davidholmes1066/LPM_Production_TT/Matlab_GUI/TRANSUS.png

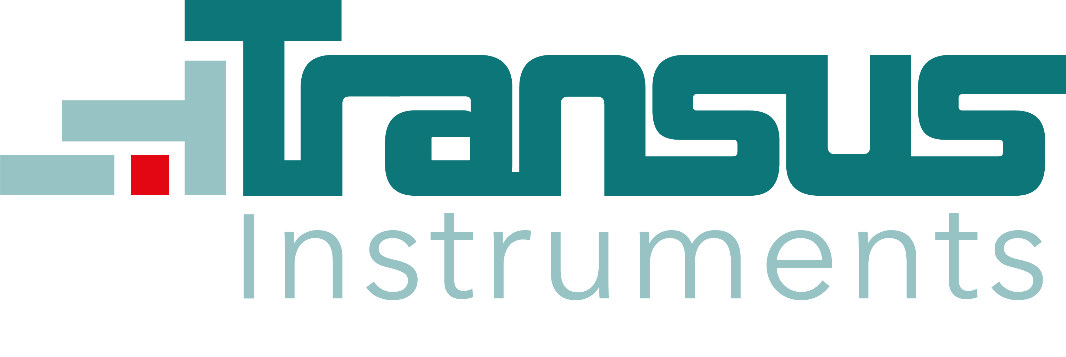
Matlab_GUI/TRANSUS.png
