davidholmes1066/LPM_Production_TT/Boards/Cover.dxf

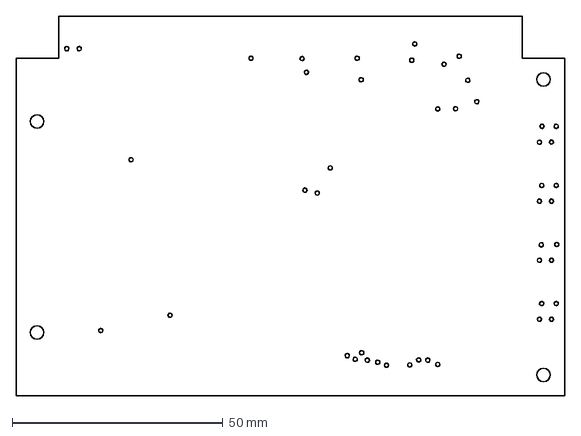
[picture p2: CAD file, 2023-02-11]
Boards/Cover.dxf
130.0 x 90.0 mm
