davidholmes1066/LPM_Production_TT/Boards/LPM_AJ_BEDOFNAILS/Bed_of_nails/Bed_of_nails.step

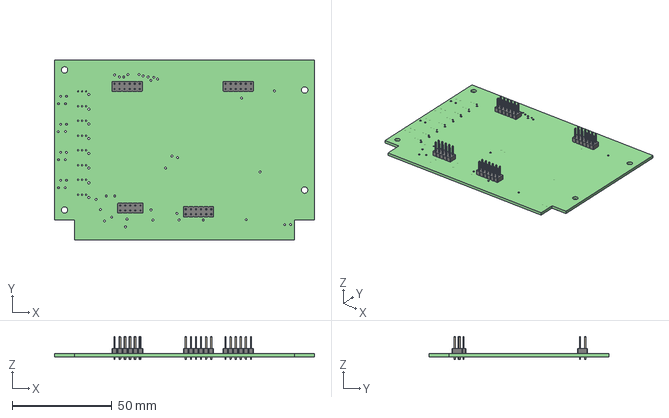
[picture p3: CAD file, 2023-02-11]
Boards/LPM_AJ_BEDOFNAILS/Bed_of_nails/Bed_of_nails.step
130.0 x 90.0 x 11.5 mm
_autosave-Bed_of_nails PCB
