davidholmes1066/LPM_Production_TT/Boards/test_board_boost/bigbirtha.dxf

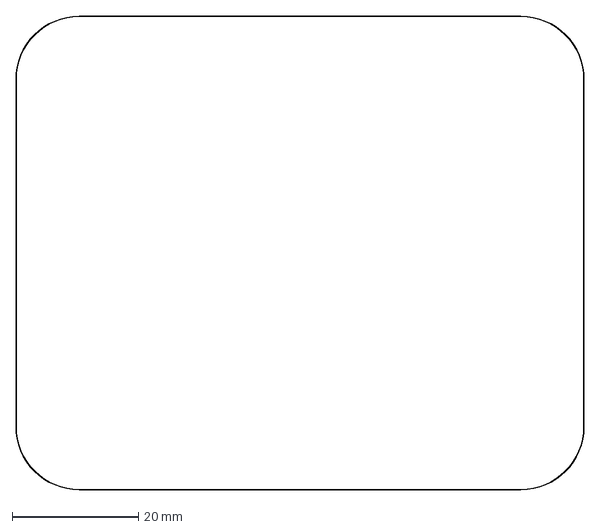
[picture p4: CAD file, 2023-02-11]
Boards/test_board_boost/bigbirtha.dxf
90.0 x 75.0 mm
