davidholmes1066/LPM_Production_TT/Boards/LPM_AJ_BEDOFNAILS/Bed_of_nails/Bed_of_nails-Edge_Cuts.dxf

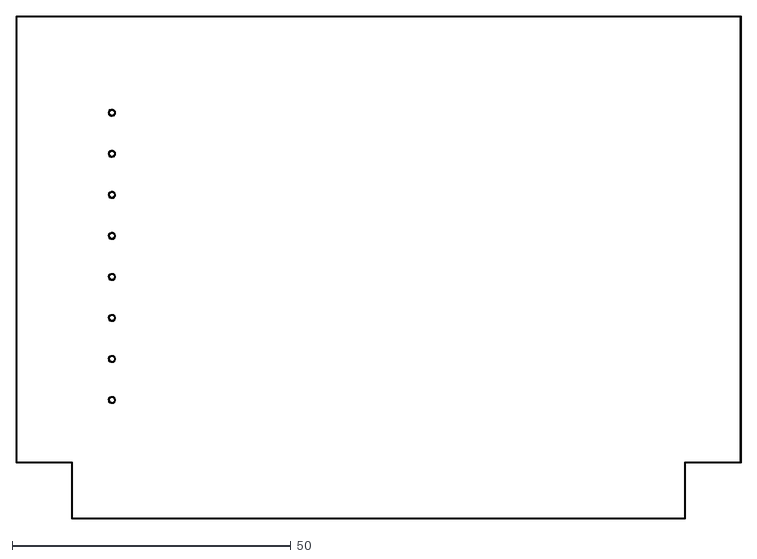
[picture p5: CAD file, 2023-02-11]
Boards/LPM_AJ_BEDOFNAILS/Bed_of_nails/Bed_of_nails-Edge_Cuts.dxf
130.1 x 90.1
