davidholmes1066/LPM_Production_TT/Boards/test_board_boost/step2dxf.step

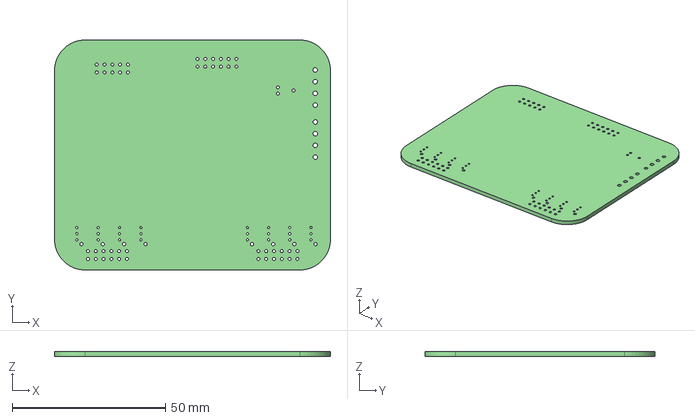
[picture p6: CAD file, 2023-02-11]
Boards/test_board_boost/step2dxf.step
90.0 x 75.0 x 1.60 mm
