davidholmes1066/LPM_Production_TT/Boards/test_board_boost/edgecut.dxf

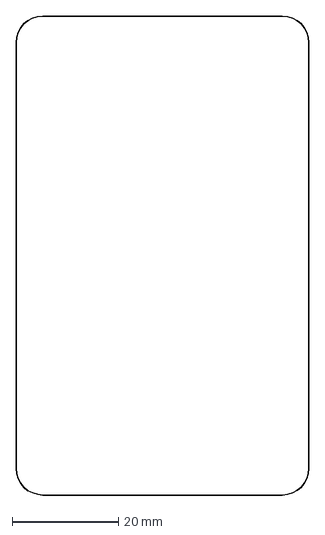
[picture p7: CAD file, 2023-02-11]
Boards/test_board_boost/edgecut.dxf
55.0 x 90.0 mm
