davidholmes1066/LPM_Production_TT/(list of files, cad)

Other CAD files:
Boards/Coverboard/Coverboard-B_Silkscreen.dxf
Boards/Coverboard/Coverboard-F_Silkscreen.dxf
Boards/LPM_AJ_BEDOFNAILS/Bed_of_nails/Bed_of_nails-B_Silkscreen.dxf
Boards/LPM_AJ_BEDOFNAILS/Bed_of_nails/Bed_of_nails-F_Silkscreen.dxf
Boards/USB/USB-B_Silkscreen.dxf
Boards/USB/USB-F_Silkscreen.dxf
Boards/test_board_boost/test_board_boost-B_Silkscreen.dxf
Boards/test_board_boost/test_board_boost-F_Silkscreen.dxf
