davidholmes1066/LPM_Production_TT/Matlab_GUI/logfiles/test123_11-02-2023.xlsx

Sheet: Logfile
Serial number | Date | PASS/ FAIL | VCC MAIN | CORE VDD | VDD 1.8 | VIO 3.0 | VPP | VIO 1.8 | BLE VDD | IBAT | IEXT | F D0 | F D1 | VOS P1 | VOS P2 | VOS P3 | VOS P4 | SNR P1U | SNR P1D | SNR P2U | SNR P2D | SNR P3U | SNR P3D | SNR P4U | SNR P4D | GAIN P1U | GAIN P1D | GAIN P2U | GAIN P2D | GAIN P3U | GAIN P3D | GAIN P4U | GAIN P4D | TEMP | PRES
test13 | 2023-02-11 19:50 | FAIL | -0.06685973437 | -0.1814976738 | -0.1859932793 | -0.1814976738 | -0.08034655078 | -0.188241082 | -0.1927366875 | 298.8080611 | -39.20463423 |  |  | 10.85872955 | 9.197671127 | 11.78317356 | 10.23971558 | 10.88460846 | 11.09811764 | 57.50366516 | 57.6351265 | 5721 | 5721 | 5566 | 18371 | 20480 | 20480

Sheet: Parameters
Test Parameters
 | VCC MAIN | CORE VDD | VDD 1.8 | VIO 3.0 | VPP | VIO 1.8 | BLE VDD | IBAT | IEXT | VOS | SNR | GAIN | Frequency | Temp | Pres
MIN | 3.22 | 1.15 | 1.76 | 2.93 | 2.43 | 1.76 | 2.93 |  |  | 308.7 | 45 | 30000 | 990 | 10 | 0.5
MAX | 3.38 | 1.25 | 1.88 | 3.07 | 2.57 | 1.88 | 3.07 | 310 | 710 | 377.3 |  | 50000 | 1010 | 600 | 100
