davidholmes1066/LPM_Production_TT/Matlab_GUI/logfiles/TEST_12-02-2023.xlsx

Sheet: Logfile
Serial number | Date | PASS/ FAIL | VCC MAIN | CORE VDD | VDD 1.8 | VIO 3.0 | VPP | VIO 1.8 | BLE VDD | IBAT | IEXT | F D0 | F D1 | VOS P1 | VOS P2 | VOS P3 | VOS P4 | SNR P1U | SNR P1D | SNR P2U | SNR P2D | SNR P3U | SNR P3D | SNR P4U | SNR P4D | GAIN P1U | GAIN P1D | GAIN P2U | GAIN P2D | GAIN P3U | GAIN P3D | GAIN P4U | GAIN P4D | TEMP | PRES
TEST | 2023-02-12 09:18 | FAIL | -0.06461193164 | -0.1680108574 | -0.188241082 | -0.1814976738 | -0.07585094531 | -0.1770020684 | -0.1904888848 | 301.3715376 | -38.8384233 |  |  | 18371 | 20480 | 20480 | 0 | 11.58883743 | 11.45199604 | 12.74043026 | 13.6725668 | 10.7099968 | 12.111866 | 49.49263916 | 45.45700607 | 5721 | 5721 | 5721 | 5721 | 5566 | 5566 | 114 | 114 | -0.1778589338 | 269.9919128
1325 | 2023-02-12 10:22 | FAIL | -0.003921257812 | -0.1837454766 | -0.1747542656 | -0.163515252 | -0.01066466602 | -0.1904888848 | -0.1792498711 | 301.3715376 | -38.8384233 |  |  | 18371 | 20480 | 20480 | 0 | 12.20718956 | 9.656385422 | 10.95156097 | 10.90866089 | 10.4581995 | 9.892720222 | 41.48161316 | 41.3976326 | 5721 | 5721 | 5721 | 5721 | 5566 | 5566 | 68.4 | 68.4 | -0.1782969534 | 269.9919128
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
