davidholmes1066/LPM_Production_TT/Boards/test_board_boost/TIP023BF_SCH.pdf

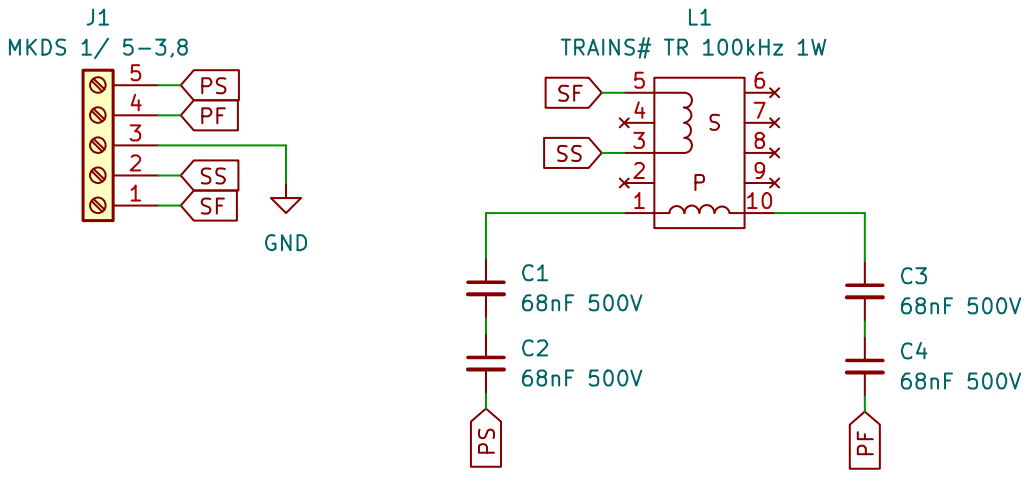
[picture p8: page 1]
