davidholmes1066/LPM_Production_TT/Boards/test_board_boost/test_board_boost.kicad_pcb

## KiCad design Boards/test_board_boost/test_board_boost.kicad_pcb (2024-06-26)

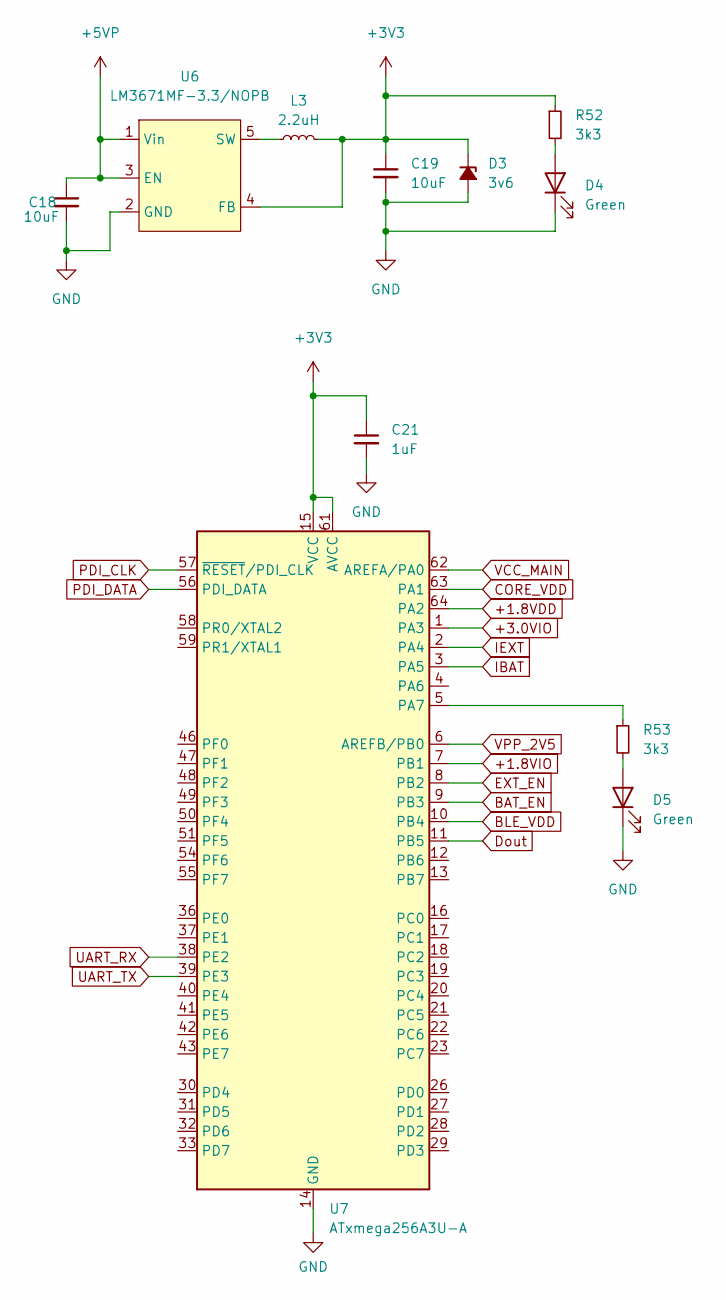
[picture p9: schematic MCU.kicad_sch]

Parts:
C18, C19: 10uF; C_0805_2012Metric_Pad1.18x1.45mm_HandSolder
C21: 1uF; C_0805_2012Metric_Pad1.18x1.45mm_HandSolder; Farnell 2346944
D3: 3v6; BZX84C3V6; Farnell 1902466
D4, D5: Green; LED_0402_1005Metric_Pad0.77x0.64mm_HandSolder; Farnell 2507544
L3: 2.2uH; 10uH_boost; Farnell 3865051
R52, R53: 3k3; R_0805_2012Metric_Pad1.20x1.40mm_HandSolder
U6: LM3671MF-3.3/NOPB; SOT-23-5_HandSoldering; Farnell 3008192
U7: ATxmega256A3U-A; TQFP-64_14x14mm_P0.8mm

Connections:
+1.8VDD: U7.64 (PA2); also elsewhere on the board
+1.8VIO: U7.7 (PB1); also elsewhere on the board
+3.0VIO: U7.1 (PA3); also elsewhere on the board
+3V3: C19.1, C21.1, D3.1 (K), L3.2, R52.1, U6.4 (FB), U7.15 (VCC), U7.25 (VCC), U7.35 (VCC), U7.45 (VCC), U7.53 (VCC), U7.61 (AVCC); also elsewhere on the board
+5VP: C18.1, U6.1 (Vin), U6.3 (EN); also elsewhere on the board
BAT_EN: U7.9 (PB3); also elsewhere on the board
BLE_VDD: U7.10 (PB4); also elsewhere on the board
CORE_VDD: U7.63 (PA1); also elsewhere on the board
Dout: U7.11 (PB5); also elsewhere on the board
EXT_EN: U7.8 (PB2); also elsewhere on the board
GND: C18.2, C19.2, C21.2, D3.2 (A), D4.1 (K), D5.1 (K), U6.2 (GND), U7.14 (GND), U7.24 (GND), U7.34 (GND), U7.44 (GND), U7.52 (GND), U7.60 (GND); also elsewhere on the board
IBAT: U7.3 (PA5); also elsewhere on the board
IEXT: U7.2 (PA4); also elsewhere on the board
unnamed: D4.2 (A), R52.2
unnamed: D5.2 (A), R53.2
unnamed: L3.1, U6.5 (SW)
unnamed: R53.1, U7.5 (PA7)
PDI_CLK: U7.57 (~RESET/PDI_CLK); also elsewhere on the board
PDI_DATA: U7.56 (PDI_DATA); also elsewhere on the board
UART_RX: U7.38 (PE2); also elsewhere on the board
UART_TX: U7.39 (PE3); also elsewhere on the board
VCC_MAIN: U7.62 (AREFA/PA0); also elsewhere on the board
VPP_2V5: U7.6 (AREFB/PB0); also elsewhere on the board

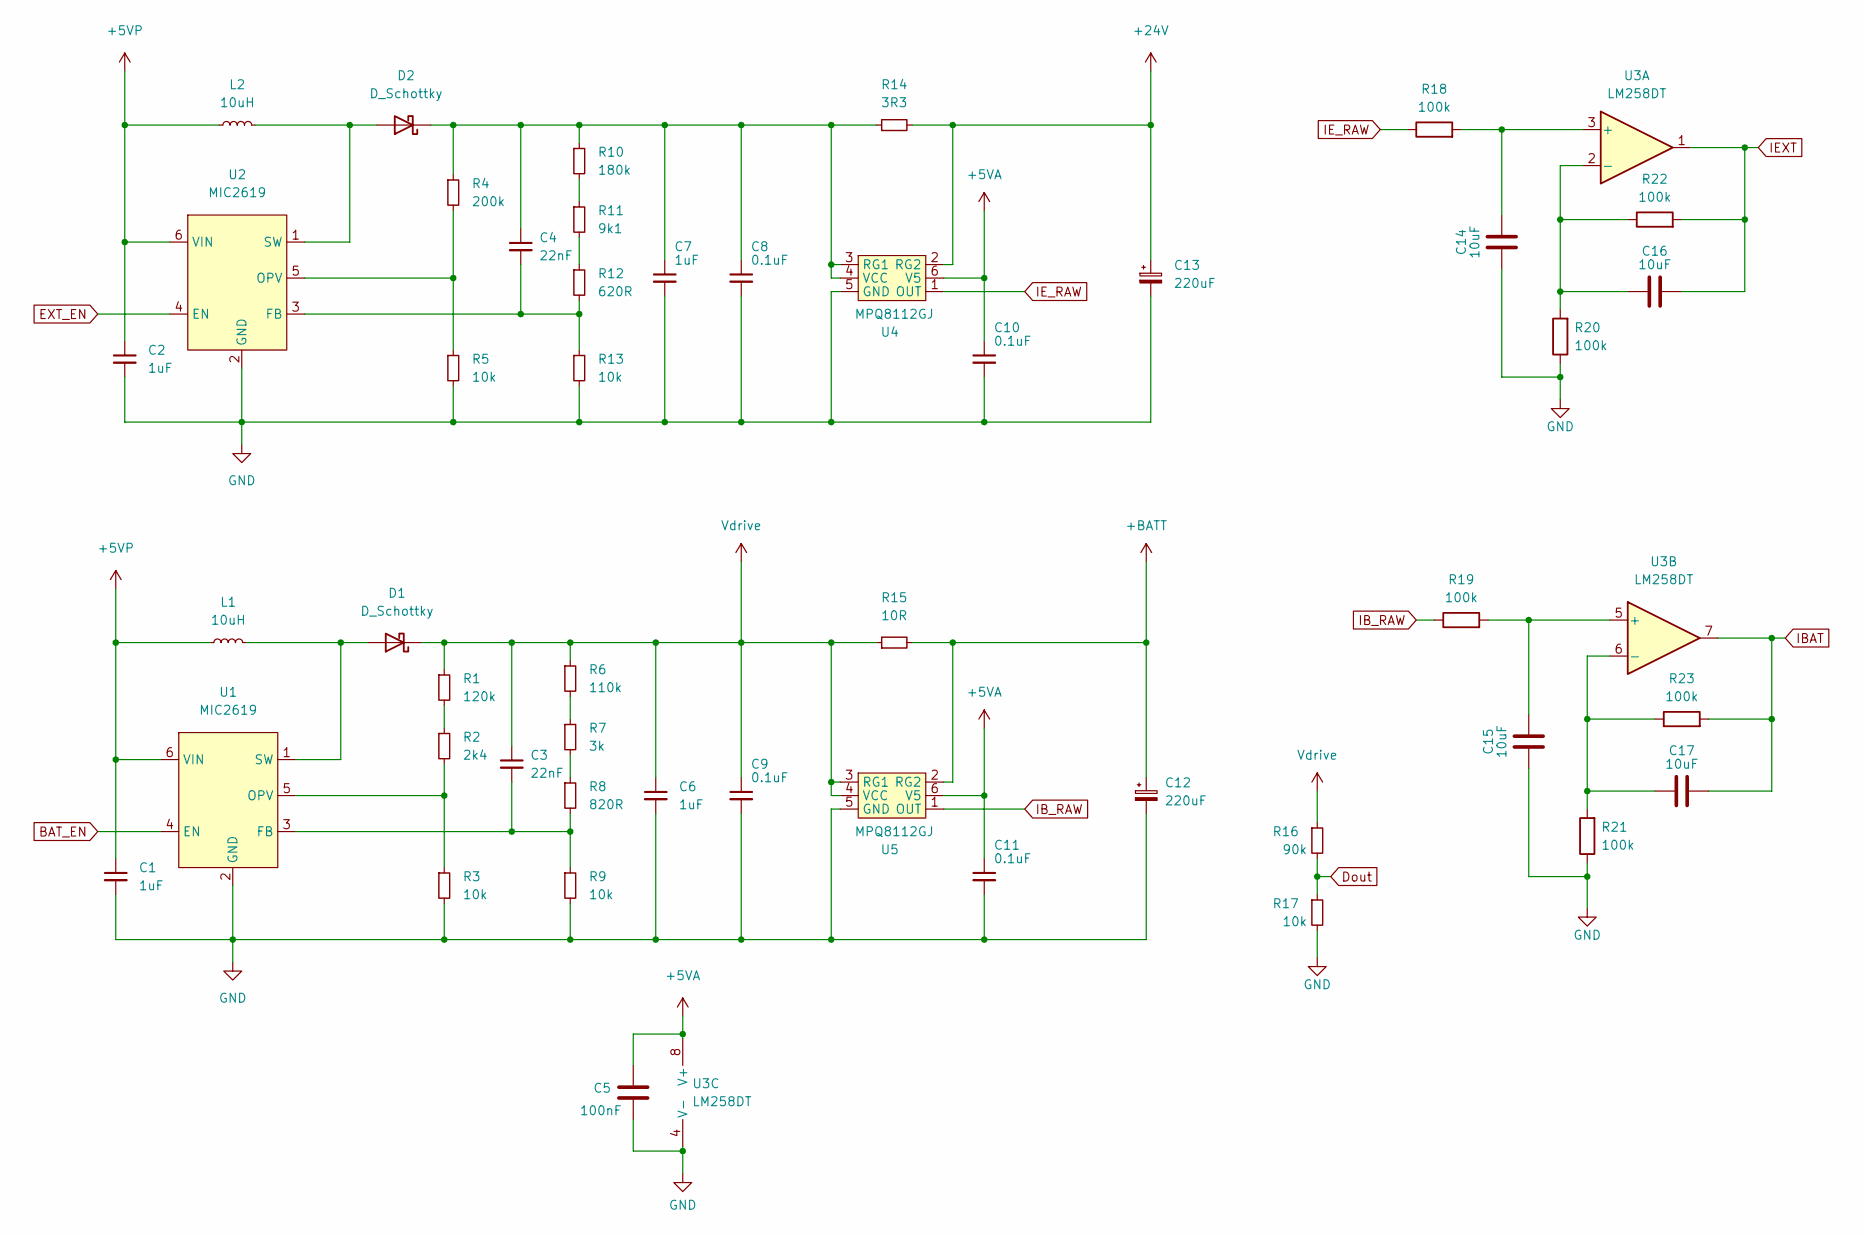
[picture p10: schematic LPM_SUP.kicad_sch]

Parts:
C1, C2, C7: 1uF; C_0805_2012Metric_Pad1.18x1.45mm_HandSolder; Farnell 2346944
C3, C4: 22nF; C_0805_2012Metric_Pad1.18x1.45mm_HandSolder
C5: 100nF; C_0805_2012Metric_Pad1.18x1.45mm_HandSolder; FARNELL 2611936
C6: 1uF; C_0805_2012Metric_Pad1.18x1.45mm_HandSolder
C8, C9, C10, C11: 0.1uF; C_0805_2012Metric_Pad1.18x1.45mm_HandSolder
C12, C13: 220uF; CP_Elec_10x10; Farnell 2471976
C14, C15, C16, C17: 10uF; C_0805_2012Metric_Pad1.18x1.45mm_HandSolder; FARNELL 2611936
D1, D2: D_Schottky; D_SOD-323; Farnell 1467544
L1, L2: 10uH; 10uH_boost; Farnell 3865054
R1: 120k; R_0805_2012Metric_Pad1.20x1.40mm_HandSolder
R2: 2k4; R_0805_2012Metric_Pad1.20x1.40mm_HandSolder
R3, R5, R9, R13, R17: 10k; R_0805_2012Metric_Pad1.20x1.40mm_HandSolder
R4: 200k; R_0805_2012Metric_Pad1.20x1.40mm_HandSolder
R6: 110k; R_0805_2012Metric_Pad1.20x1.40mm_HandSolder
R7: 3k; R_0805_2012Metric_Pad1.20x1.40mm_HandSolder
R8: 820R; R_0805_2012Metric_Pad1.20x1.40mm_HandSolder
R10: 180k; R_0805_2012Metric_Pad1.20x1.40mm_HandSolder
R11: 9k1; R_0805_2012Metric_Pad1.20x1.40mm_HandSolder
R12: 620R; R_0805_2012Metric_Pad1.20x1.40mm_HandSolder
R14: 3R3; R_0805_2012Metric_Pad1.20x1.40mm_HandSolder
R15: 10R; R_0805_2012Metric_Pad1.20x1.40mm_HandSolder
R16: 90k; R_0805_2012Metric_Pad1.20x1.40mm_HandSolder
R18, R19, R20, R21, R22, R23: 100k; R_0805_2012Metric_Pad1.20x1.40mm_HandSolder
U1, U2: MIC2619; MIC2619YD6-TR; Farnell 2509963
U3: LM258DT; SO-8_5.3x6.2mm_P1.27mm; Farnell 2382607
U4, U5: MPQ8112GJ; SOT-23-6_Handsoldering; Farnell 3922485

Connections:
+5VP: C1.1, C2.1, C5.1, C10.1, C11.1, L1.1, L2.1, U1.6 (VIN), U2.6 (VIN), U3.8 (V+), U4.6 (V5), U5.6 (V5); also elsewhere on the board
+24V: C13.1, R14.2, U4.2 (RG2); also elsewhere on the board
+BATT: C12.1, R15.2, U5.2 (RG2); also elsewhere on the board
BAT_EN: U1.4 (EN); also elsewhere on the board
Dout: R16.2, R17.1; also elsewhere on the board
EXT_EN: U2.4 (EN); also elsewhere on the board
GND: C1.2, C2.2, C5.2, C6.2, C7.2, C8.2, C9.2, C10.2, C11.2, C12.2, C13.2, C14.1, C15.1, R3.2, R5.2, R9.2, R13.2, R17.2, R20.1, R21.1, U1.2 (GND), U2.2 (GND), U3.4 (V-), U4.5 (GND), U5.5 (GND); also elsewhere on the board
IBAT: C17.2, R23.2, U3.7; also elsewhere on the board
IB_RAW: R19.1, U5.1 (OUT)
IEXT: C16.2, R22.2, U3.1; also elsewhere on the board
IE_RAW: R18.1, U4.1 (OUT)
unnamed: C3.2, R8.2, R9.1, U1.3 (FB)
unnamed: C4.1, C7.1, C8.1, D2.1 (K), R4.1, R10.1, R14.1, U4.3 (RG1), U4.4 (VCC)
unnamed: C4.2, R12.2, R13.1, U2.3 (FB)
unnamed: C14.2, R18.2, U3.3 (+)
unnamed: C15.2, R19.2, U3.5 (+)
unnamed: C16.1, R20.2, R22.1, U3.2 (-)
unnamed: C17.1, R21.2, R23.1, U3.6 (-)
unnamed: D1.2 (A), L1.2, U1.1 (SW)
unnamed: D2.2 (A), L2.2, U2.1 (SW)
unnamed: R1.2, R2.1
unnamed: R2.2, R3.1, U1.5 (OPV)
unnamed: R4.2, R5.1, U2.5 (OPV)
unnamed: R6.2, R7.1
unnamed: R7.2, R8.1
unnamed: R10.2, R11.1
unnamed: R11.2, R12.1
Vdrive: C3.1, C6.1, C9.1, D1.1 (K), R1.1, R6.1, R15.1, R16.1, U5.3 (RG1), U5.4 (VCC)

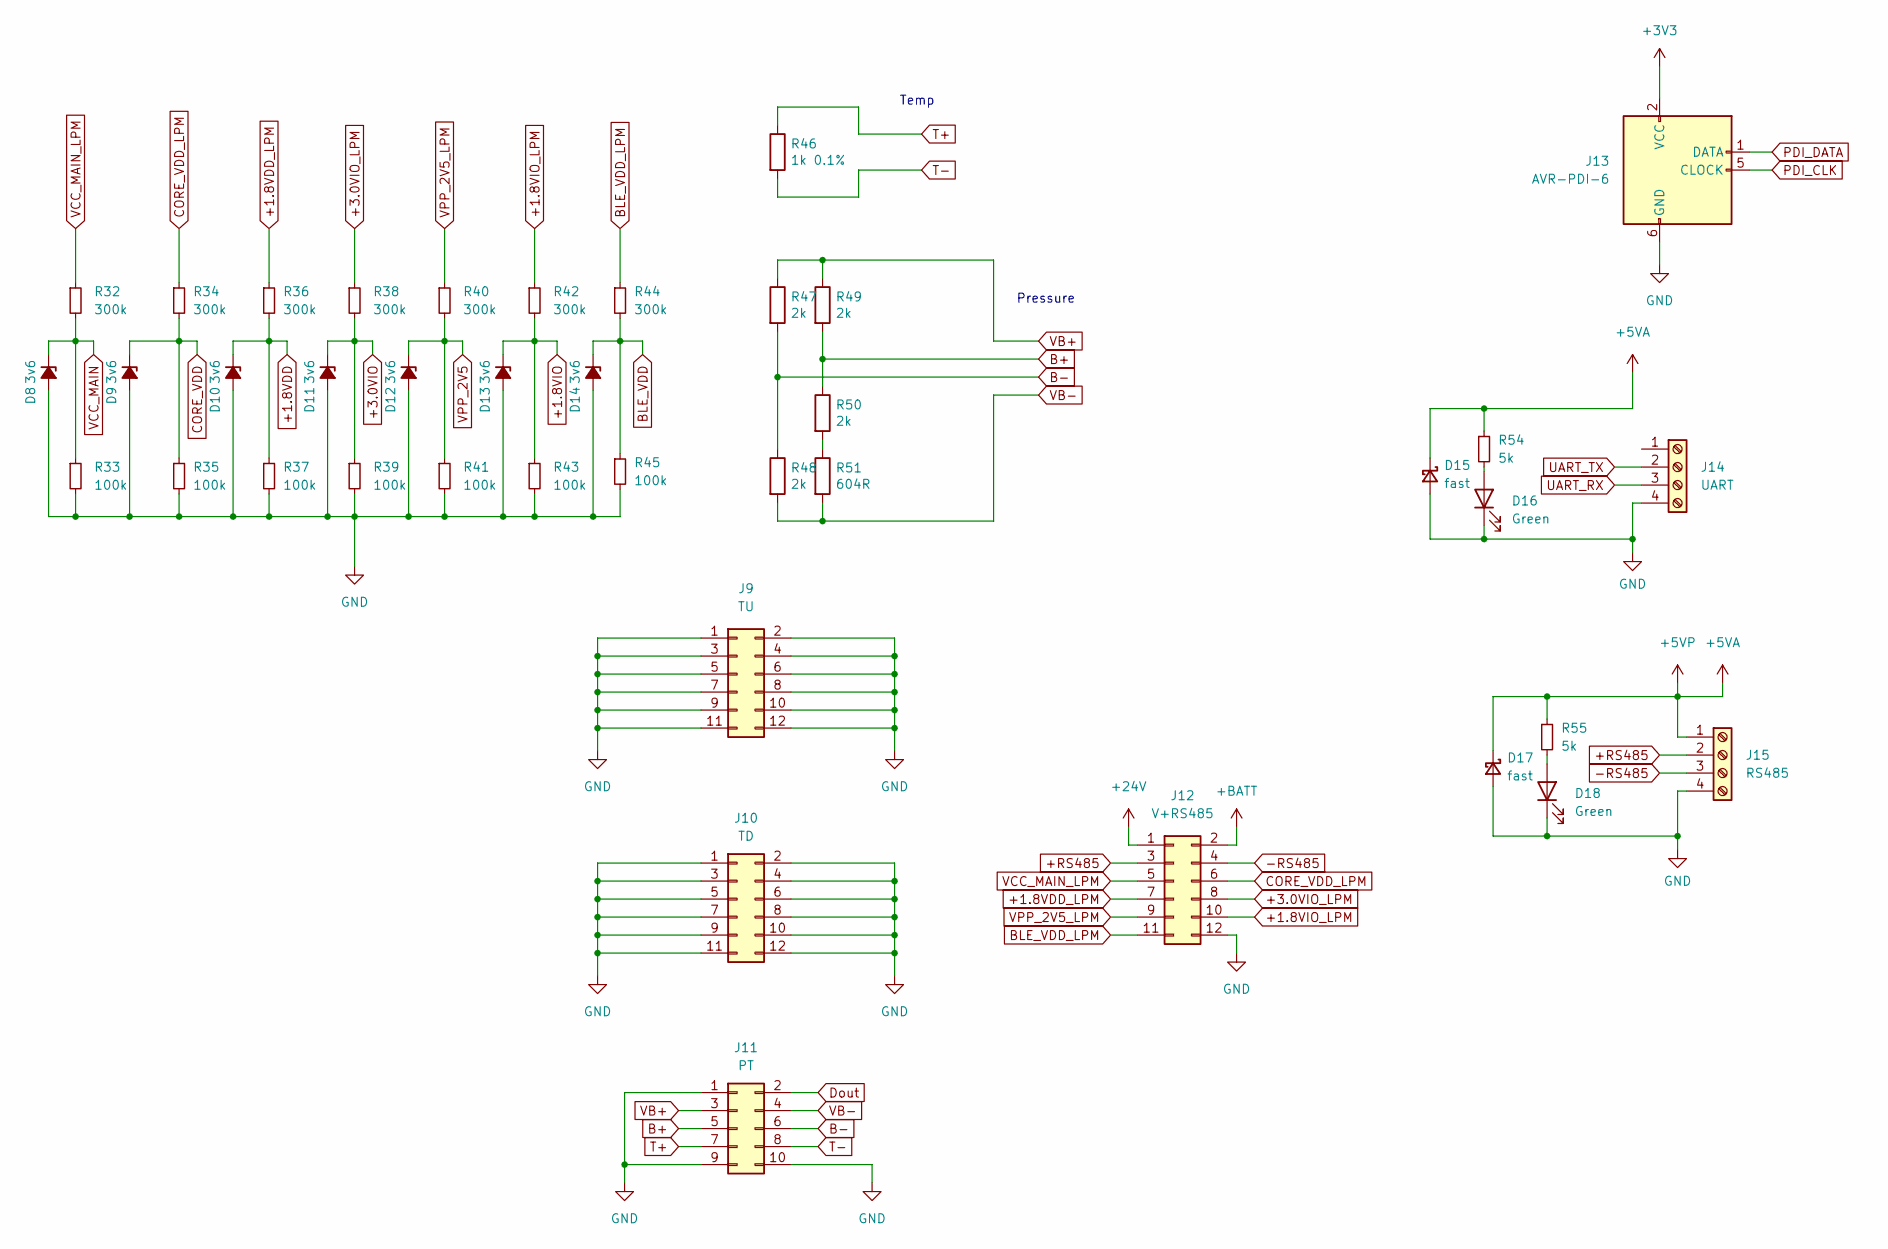
[picture p11: schematic cons.kicad_sch]

Parts:
D8, D9, D10, D11, D12, D13, D14: 3v6; BZX84C3V6; Farnell 1902466
D15, D17: fast; D_SOD-128; Farnell 1829204
D16, D18: Green; LED_0402_1005Metric_Pad0.77x0.64mm_HandSolder; Farnell 2507544
J9: TU; PinHeader_2x06_P2.54mm_Vertical
J10: TD; PinHeader_2x06_P2.54mm_Vertical
J11: PT; PinHeader_2x05_P2.54mm_Vertical
J12: V+RS485; PinHeader_2x06_P2.54mm_Vertical
J13: AVR-PDI-6; AVR-PDI-TAG-CONNECT
J14: UART; 4pos_terminal; Farnell 2007987
J15: RS485; 4pos_terminal; Farnell 2007987
R32, R34, R36, R38, R40, R42, R44: 300k; R_0805_2012Metric_Pad1.20x1.40mm_HandSolder
R33, R35, R37, R39, R41, R43, R45: 100k; R_0805_2012Metric_Pad1.20x1.40mm_HandSolder
R46: 1k 0.1%; R_0805_2012Metric_Pad1.20x1.40mm_HandSolder
R47, R48, R49, R50: 2k; R_0805_2012Metric_Pad1.20x1.40mm_HandSolder
R51: 604R; R_0805_2012Metric_Pad1.20x1.40mm_HandSolder
R54, R55: 5k; R_0805_2012Metric_Pad1.20x1.40mm_HandSolder

Connections:
+1.8VDD: D10.1 (K), R36.2, R37.1; also elsewhere on the board
+1.8VDD_LPM: J12.7, R36.1
+1.8VIO: D13.1 (K), R42.2, R43.1; also elsewhere on the board
+1.8VIO_LPM: J12.10, R42.1
+3.0VIO: D11.1 (K), R38.2, R39.1; also elsewhere on the board
+3.0VIO_LPM: J12.8, R38.1
+3V3: J13.2 (VCC); also elsewhere on the board
+5VP: D15.1 (K), D17.1 (K), J15.1, R54.1, R55.1; also elsewhere on the board
+24V: J12.1; also elsewhere on the board
+BATT: J12.2; also elsewhere on the board
+RS485: J12.3, J15.2
-RS485: J12.4, J15.3
B+: J11.5, R49.2, R50.1
B-: J11.6, R47.2, R48.1
BLE_VDD: D14.1 (K), R44.2, R45.1; also elsewhere on the board
BLE_VDD_LPM: J12.11, R44.1
CORE_VDD: D9.1 (K), R34.2, R35.1; also elsewhere on the board
CORE_VDD_LPM: J12.6, R34.1
Dout: J11.2; also elsewhere on the board
GND: D8.2 (A), D9.2 (A), D10.2 (A), D11.2 (A), D12.2 (A), D13.2 (A), D14.2 (A), D15.2 (A), D16.1 (K), D17.2 (A), D18.1 (K), J9.1, J9.2, J9.3, J9.4, J9.5, J9.6, J9.7, J9.8, J9.9, J9.10, J9.11, J9.12, J10.1, J10.2, J10.3, J10.4, J10.5, J10.6, J10.7, J10.8, J10.9, J10.10, J10.11, J10.12, J11.1, J11.9, J11.10, J12.12, J13.6 (GND), J14.4, J15.4, R33.2, R35.2, R37.2, R39.2, R41.2, R43.2, R45.2; also elsewhere on the board
unnamed: D16.2 (A), R54.2
unnamed: D18.2 (A), R55.2
unnamed: R50.2, R51.1
PDI_CLK: J13.5 (CLOCK); also elsewhere on the board
PDI_DATA: J13.1 (DATA); also elsewhere on the board
T+: J11.7, R46.1
T-: J11.8, R46.2
UART_RX: J14.3; also elsewhere on the board
UART_TX: J14.2; also elsewhere on the board
VB+: J11.3, R47.1, R49.1
VB-: J11.4, R48.2, R51.2
VCC_MAIN: D8.1 (K), R32.2, R33.1; also elsewhere on the board
VCC_MAIN_LPM: J12.5, R32.1
VPP_2V5: D12.1 (K), R40.2, R41.1; also elsewhere on the board
VPP_2V5_LPM: J12.9, R40.1

Notes on the sheet:
Pressure
Temp

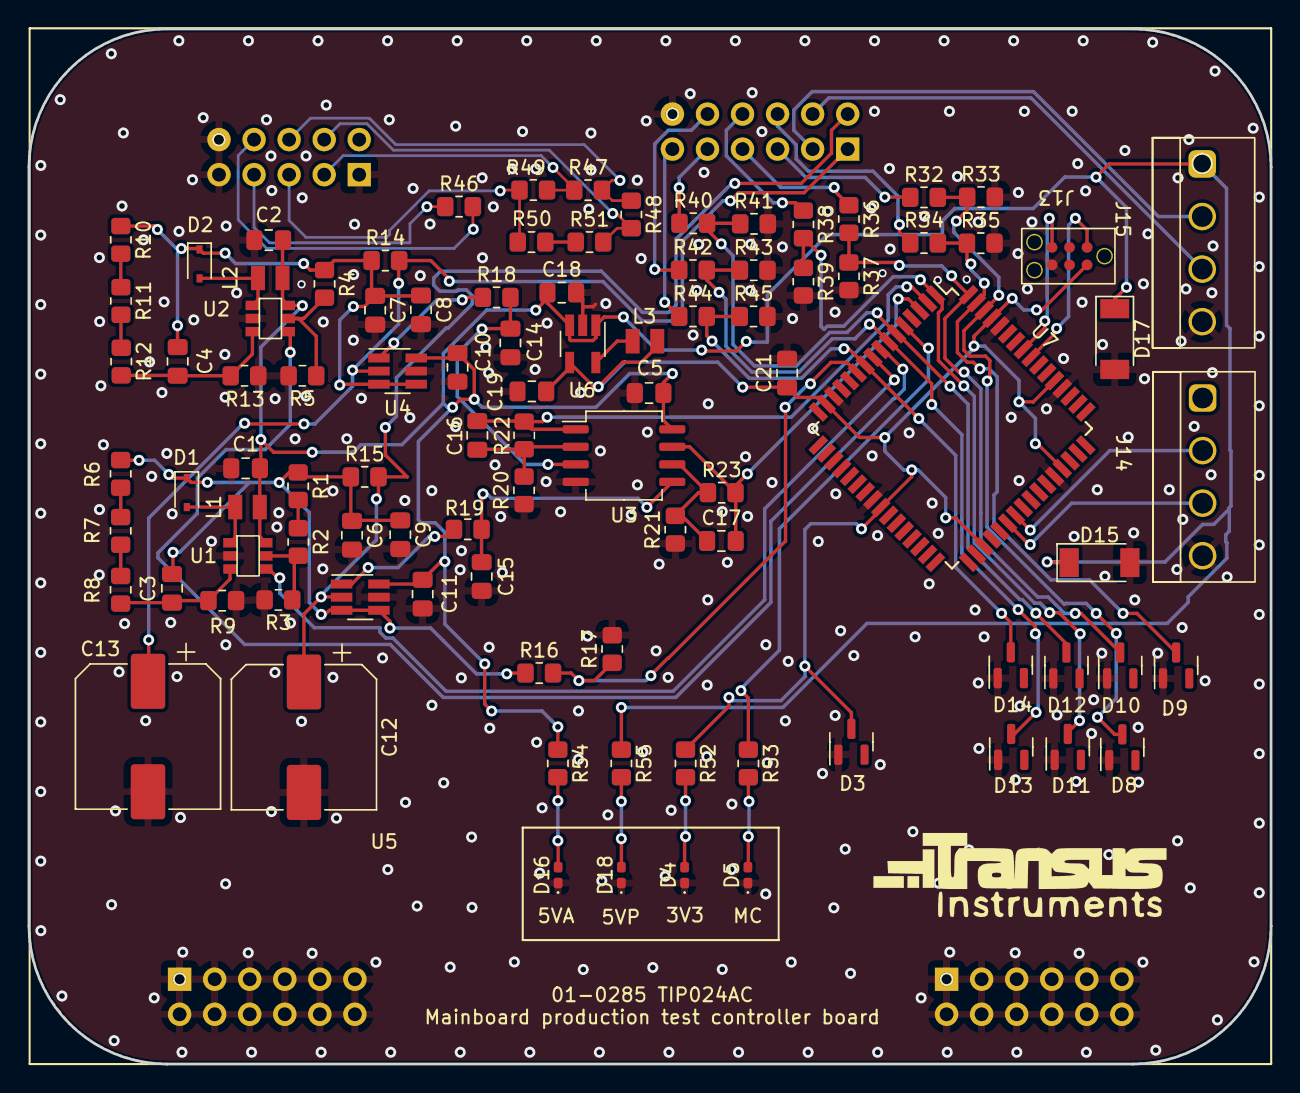
[picture p12: board test_board_boost.kicad_pcb from above]

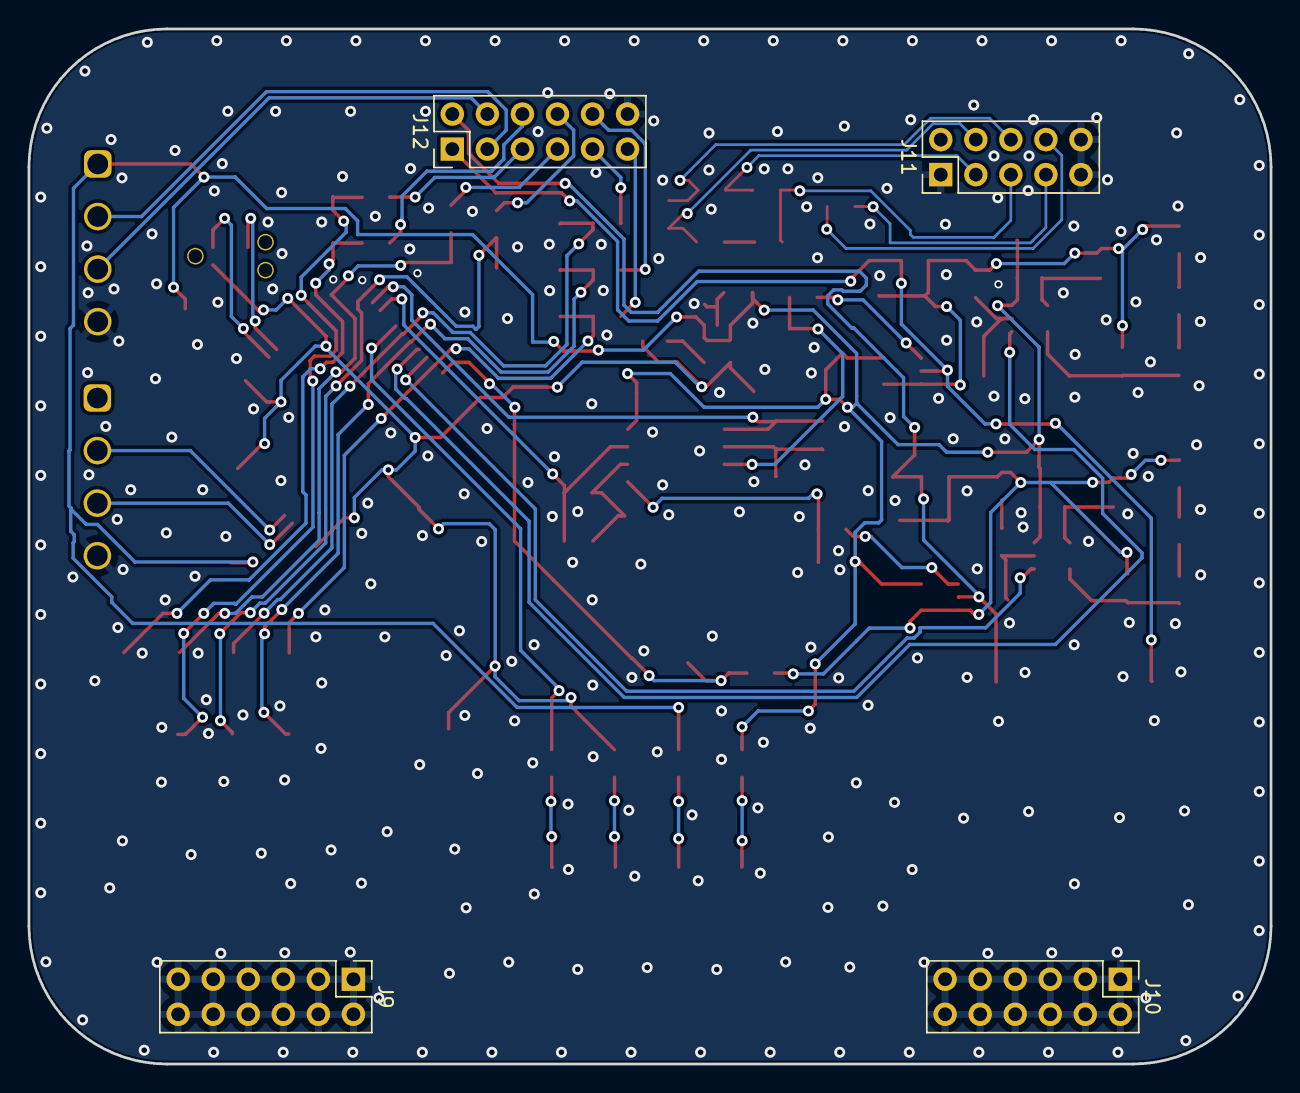
[picture p13: board test_board_boost.kicad_pcb from below]

Board: 4 copper layers, 90.0 x 75.0 mm, 100 parts (4 on the bottom side), 62 nets.
