davidholmes1066/LPM_Production_TT/Boards/LPM_AJ_BEDOFNAILS/Bed_of_nails/Bed_of_nails.kicad_pcb

## KiCad design Boards/LPM_AJ_BEDOFNAILS/Bed_of_nails/Bed_of_nails.kicad_pcb (2024-06-26)

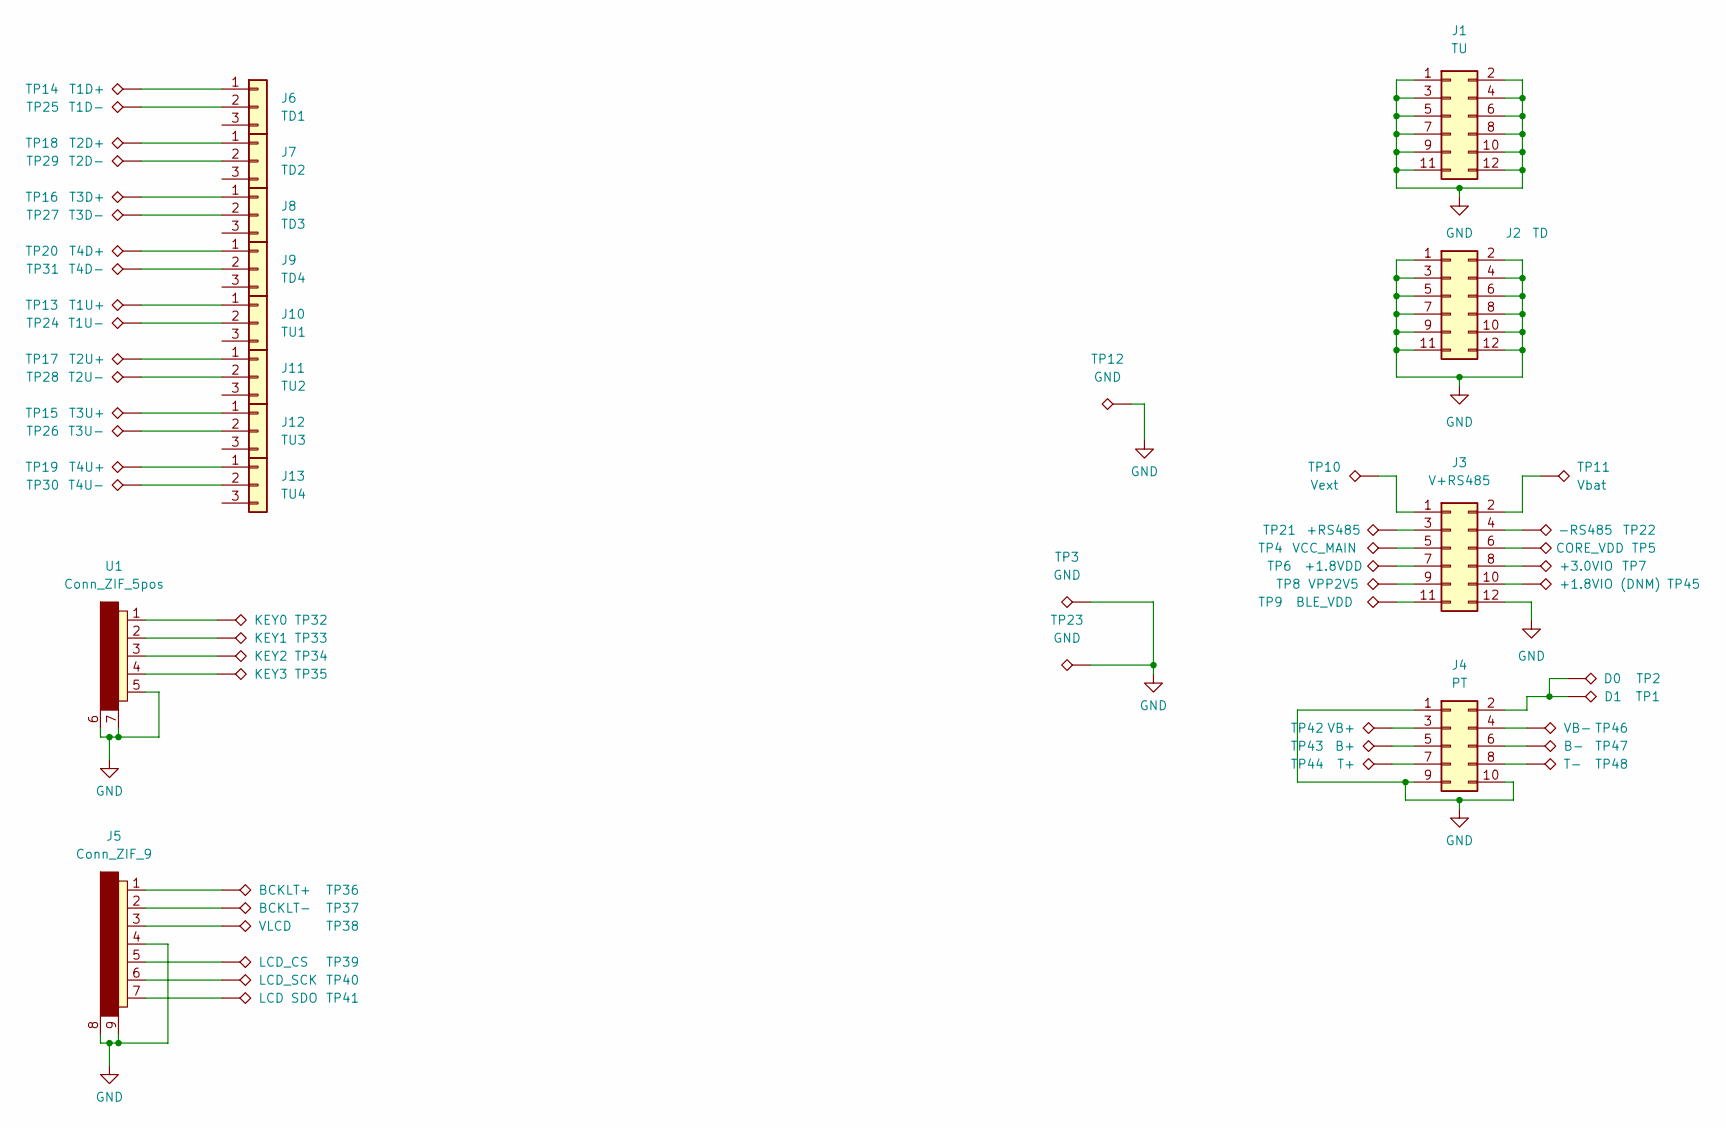
[picture p14: schematic Bed_of_nails.kicad_sch]

Parts:
J1: TU; PinHeader_2x06_P2.54mm_Vertical; Farnell 2827902
J2: TD; PinHeader_2x06_P2.54mm_Vertical; Farnell 2827902
J3: V+RS485; PinHeader_2x06_P2.54mm_Vertical; Farnell 2827902
J4: PT; PinHeader_2x05_P2.54mm_Vertical; Farnell 1593490
J5: Conn_ZIF_9; Conn_ZIF_7pos; Farnell 3215773
J6: TD1; Molex_55487-0319_LPMTRANS
J7: TD2; Molex_55487-0319_LPMTRANS
J8: TD3; Molex_55487-0319_LPMTRANS
J9: TD4; Molex_55487-0319_LPMTRANS
J10: TU1; Molex_55487-0319_LPMTRANS
J11: TU2; Molex_55487-0319_LPMTRANS
J12: TU3; Molex_55487-0319_LPMTRANS
J13: TU4; Molex_55487-0319_LPMTRANS
TP1: D1; INGUN_KS-075-47-G-10_KS-07547G10
TP2: D0; INGUN_KS-075-47-G-10_KS-07547G10
TP3, TP12, TP23: GND; INGUN_KS-075-47-G-10_KS-07547G10
TP4: VCC_MAIN; INGUN_KS-075-47-G-10_KS-07547G10
TP5: CORE_VDD; INGUN_KS-075-47-G-10_KS-07547G10
TP6: +1.8VDD; INGUN_KS-075-47-G-10_KS-07547G10
TP7: +3.0VIO; INGUN_KS-075-47-G-10_KS-07547G10
TP8: VPP2V5; INGUN_KS-075-47-G-10_KS-07547G10
TP9: BLE_VDD; INGUN_KS-075-47-G-10_KS-07547G10
TP10: Vext; INGUN_KS-075-47-G-10_KS-07547G10
TP11: Vbat; INGUN_KS-075-47-G-10_KS-07547G10
TP13: T1U+; INGUN_KS-075-47-G-10_KS-07547G10
TP14: T1D+; INGUN_KS-075-47-G-10_KS-07547G10
TP15: T3U+; INGUN_KS-075-47-G-10_KS-07547G10
TP16: T3D+; INGUN_KS-075-47-G-10_KS-07547G10
TP17: T2U+; INGUN_KS-075-47-G-10_KS-07547G10
TP18: T2D+; INGUN_KS-075-47-G-10_KS-07547G10
TP19: T4U+; INGUN_KS-075-47-G-10_KS-07547G10
TP20: T4D+; INGUN_KS-075-47-G-10_KS-07547G10
TP21: +RS485; INGUN_KS-075-47-G-10_KS-07547G10
TP22: -RS485; INGUN_KS-075-47-G-10_KS-07547G10
TP24: T1U-; INGUN_KS-075-47-G-10_KS-07547G10
TP25: T1D-; INGUN_KS-075-47-G-10_KS-07547G10
TP26: T3U-; INGUN_KS-075-47-G-10_KS-07547G10
TP27: T3D-; INGUN_KS-075-47-G-10_KS-07547G10
TP28: T2U-; INGUN_KS-075-47-G-10_KS-07547G10
TP29: T2D-; INGUN_KS-075-47-G-10_KS-07547G10
TP30: T4U-; INGUN_KS-075-47-G-10_KS-07547G10
TP31: T4D-; INGUN_KS-075-47-G-10_KS-07547G10
TP32: KEY0; INGUN_KS-075-47-G-10_KS-07547G10
TP33: KEY1; INGUN_KS-075-47-G-10_KS-07547G10
TP34: KEY2; INGUN_KS-075-47-G-10_KS-07547G10
TP35: KEY3; INGUN_KS-075-47-G-10_KS-07547G10
TP36: BCKLT+; INGUN_KS-075-47-G-10_KS-07547G10
TP37: BCKLT-; INGUN_KS-075-47-G-10_KS-07547G10
TP38: VLCD; INGUN_KS-075-47-G-10_KS-07547G10
TP39: LCD_CS; INGUN_KS-075-47-G-10_KS-07547G10
TP40: LCD_SCK; INGUN_KS-075-47-G-10_KS-07547G10
TP41: LCD SDO; INGUN_KS-075-47-G-10_KS-07547G10
TP42: VB+; INGUN_KS-075-47-G-10_KS-07547G10
TP43: B+; INGUN_KS-075-47-G-10_KS-07547G10
TP44: T+; INGUN_KS-075-47-G-10_KS-07547G10
TP45: +1.8VIO (DNM); INGUN_KS-075-47-G-10_KS-07547G10
TP46: VB-; INGUN_KS-075-47-G-10_KS-07547G10
TP47: B-; INGUN_KS-075-47-G-10_KS-07547G10
TP48: T-; INGUN_KS-075-47-G-10_KS-07547G10
U1: Conn_ZIF_5pos; Farnell 3215771

Connections:
GND: J1.1, J1.2, J1.3, J1.4, J1.5, J1.6, J1.7, J1.8, J1.9, J1.10, J1.11, J1.12, J2.1, J2.2, J2.3, J2.4, J2.5, J2.6, J2.7, J2.8, J2.9, J2.10, J2.11, J2.12, J3.12, J4.1, J4.9, J4.10, J5.4, J5.8, J5.9, TP3.1, TP12.1, TP23.1, U1.5, U1.6, U1.7
unnamed: J3.1, TP10.1
unnamed: J3.2, TP11.1
unnamed: J3.3, TP21.1
unnamed: J3.4, TP22.1
unnamed: J3.5, TP4.1
unnamed: J3.6, TP5.1
unnamed: J3.7, TP6.1
unnamed: J3.8, TP7.1
unnamed: J3.9, TP8.1
unnamed: J3.10, TP45.1
unnamed: J3.11, TP9.1
unnamed: J4.2, TP1.1, TP2.1
unnamed: J4.3, TP42.1
unnamed: J4.4, TP46.1
unnamed: J4.5, TP43.1
unnamed: J4.6, TP47.1
unnamed: J4.7, TP44.1
unnamed: J4.8, TP48.1
unnamed: J5.1, TP36.1
unnamed: J5.2, TP37.1
unnamed: J5.3, TP38.1
unnamed: J5.5, TP39.1
unnamed: J5.6, TP40.1
unnamed: J5.7, TP41.1
unnamed: J6.1, TP14.1
unnamed: J6.2, TP25.1
unnamed: J7.1, TP18.1
unnamed: J7.2, TP29.1
unnamed: J8.1, TP16.1
unnamed: J8.2, TP27.1
unnamed: J9.1, TP20.1
unnamed: J9.2, TP31.1
unnamed: J10.1, TP13.1
unnamed: J10.2, TP24.1
unnamed: J11.1, TP17.1
unnamed: J11.2, TP28.1
unnamed: J12.1, TP15.1
unnamed: J12.2, TP26.1
unnamed: J13.1, TP19.1
unnamed: J13.2, TP30.1
unnamed: TP32.1, U1.1
unnamed: TP33.1, U1.2
unnamed: TP34.1, U1.3
unnamed: TP35.1, U1.4

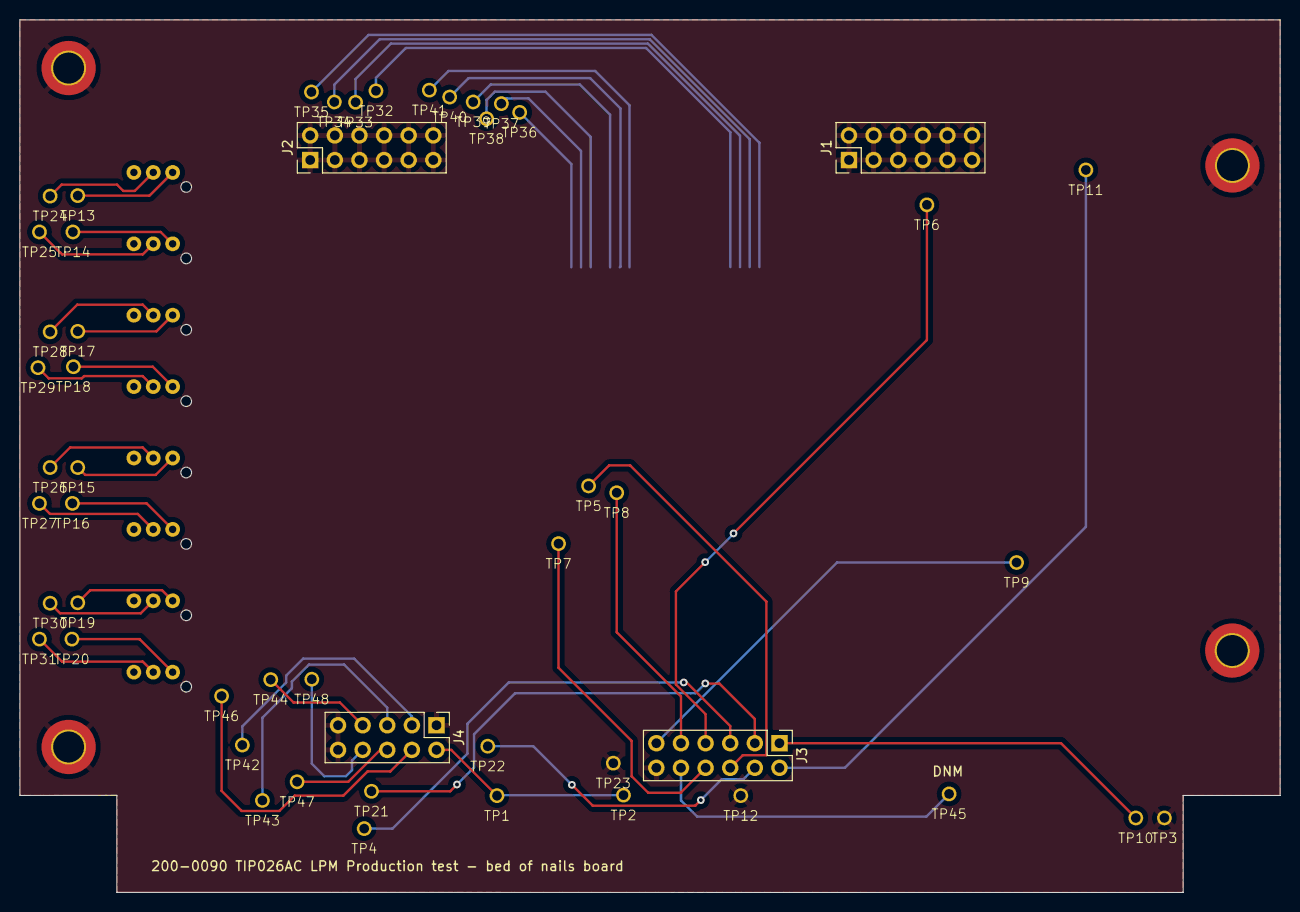
[picture p15: board Bed_of_nails.kicad_pcb from above]

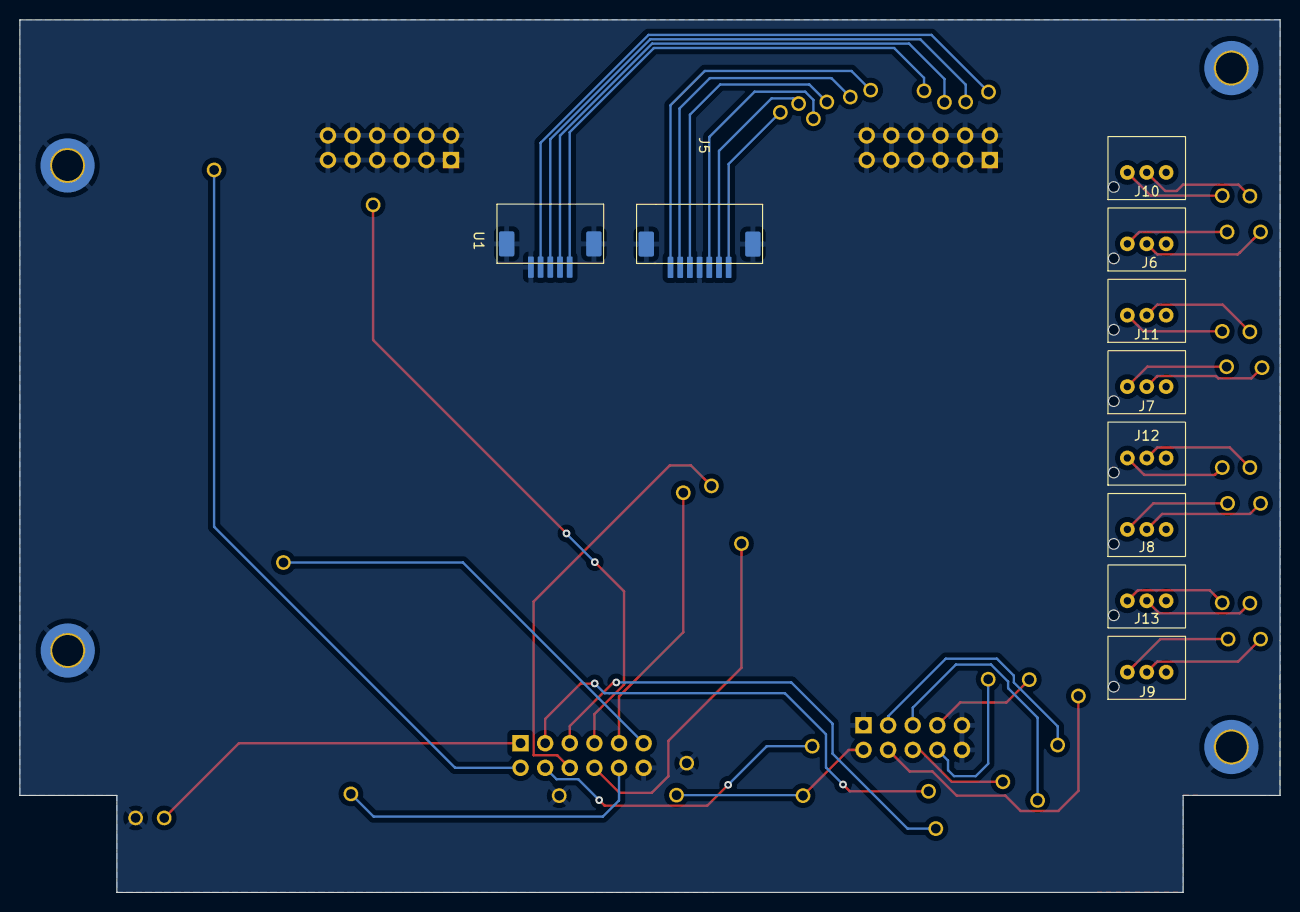
[picture p16: board Bed_of_nails.kicad_pcb from below]

Board: 2 copper layers, 130.0 x 90.0 mm, 62 parts (10 on the bottom side), 45 nets.
