davidholmes1066/LPM_Production_TT/Boards/TestBoardArduino/TestBoardArduino.kicad_pcb

## KiCad design Boards/TestBoardArduino/TestBoardArduino.kicad_pcb (2024-06-26)

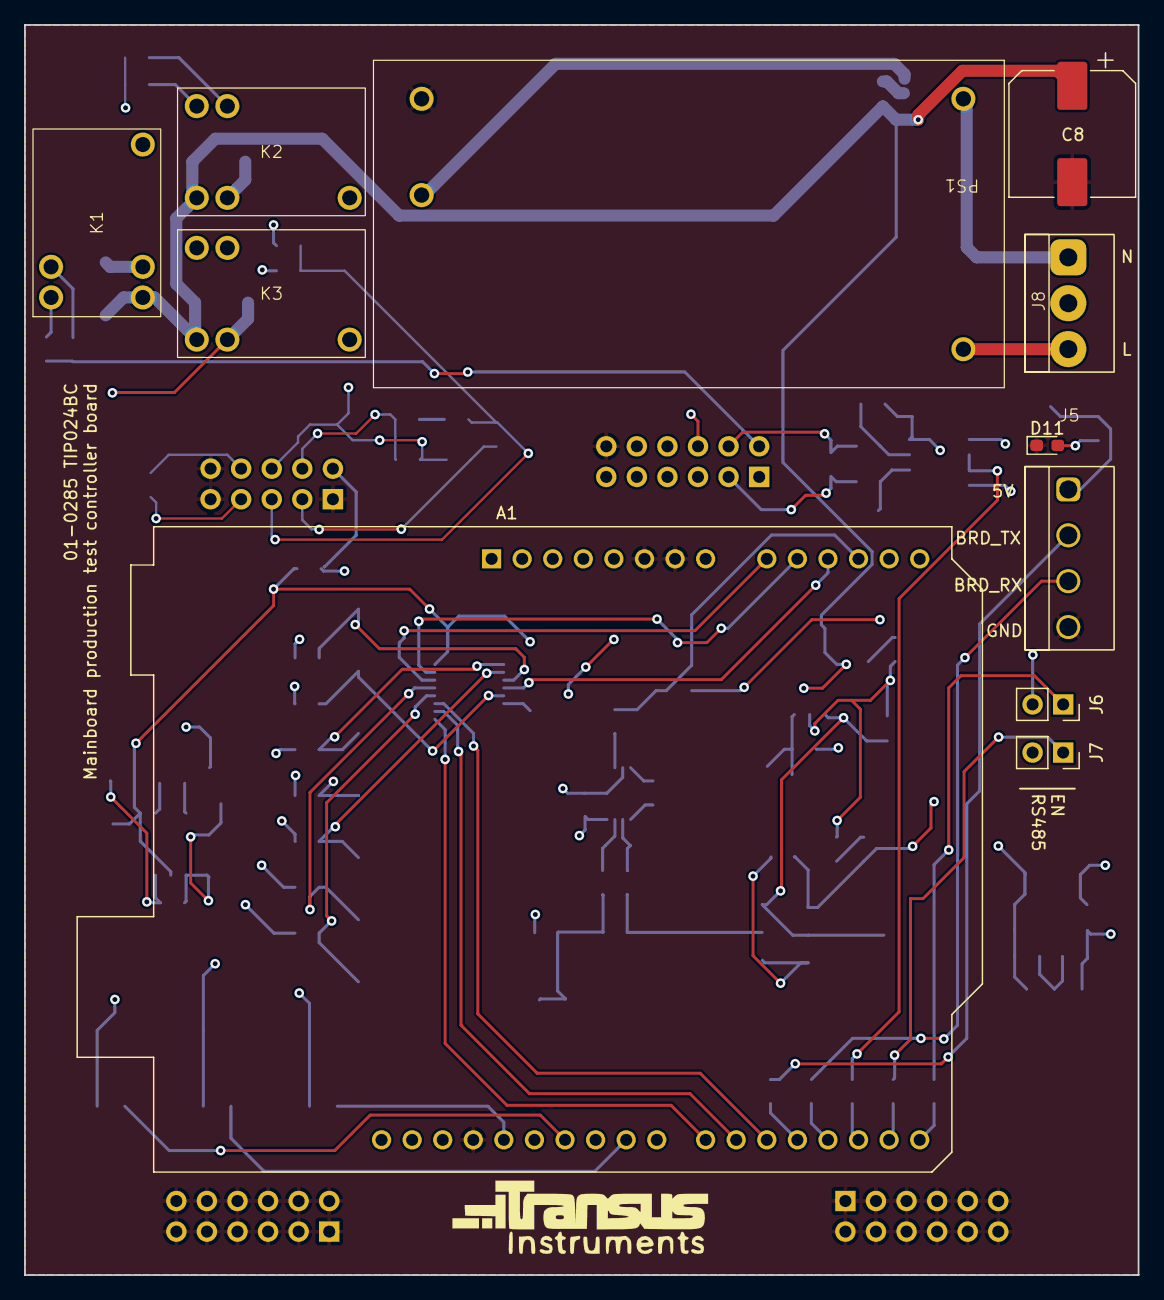
[picture p17: board TestBoardArduino.kicad_pcb from above]

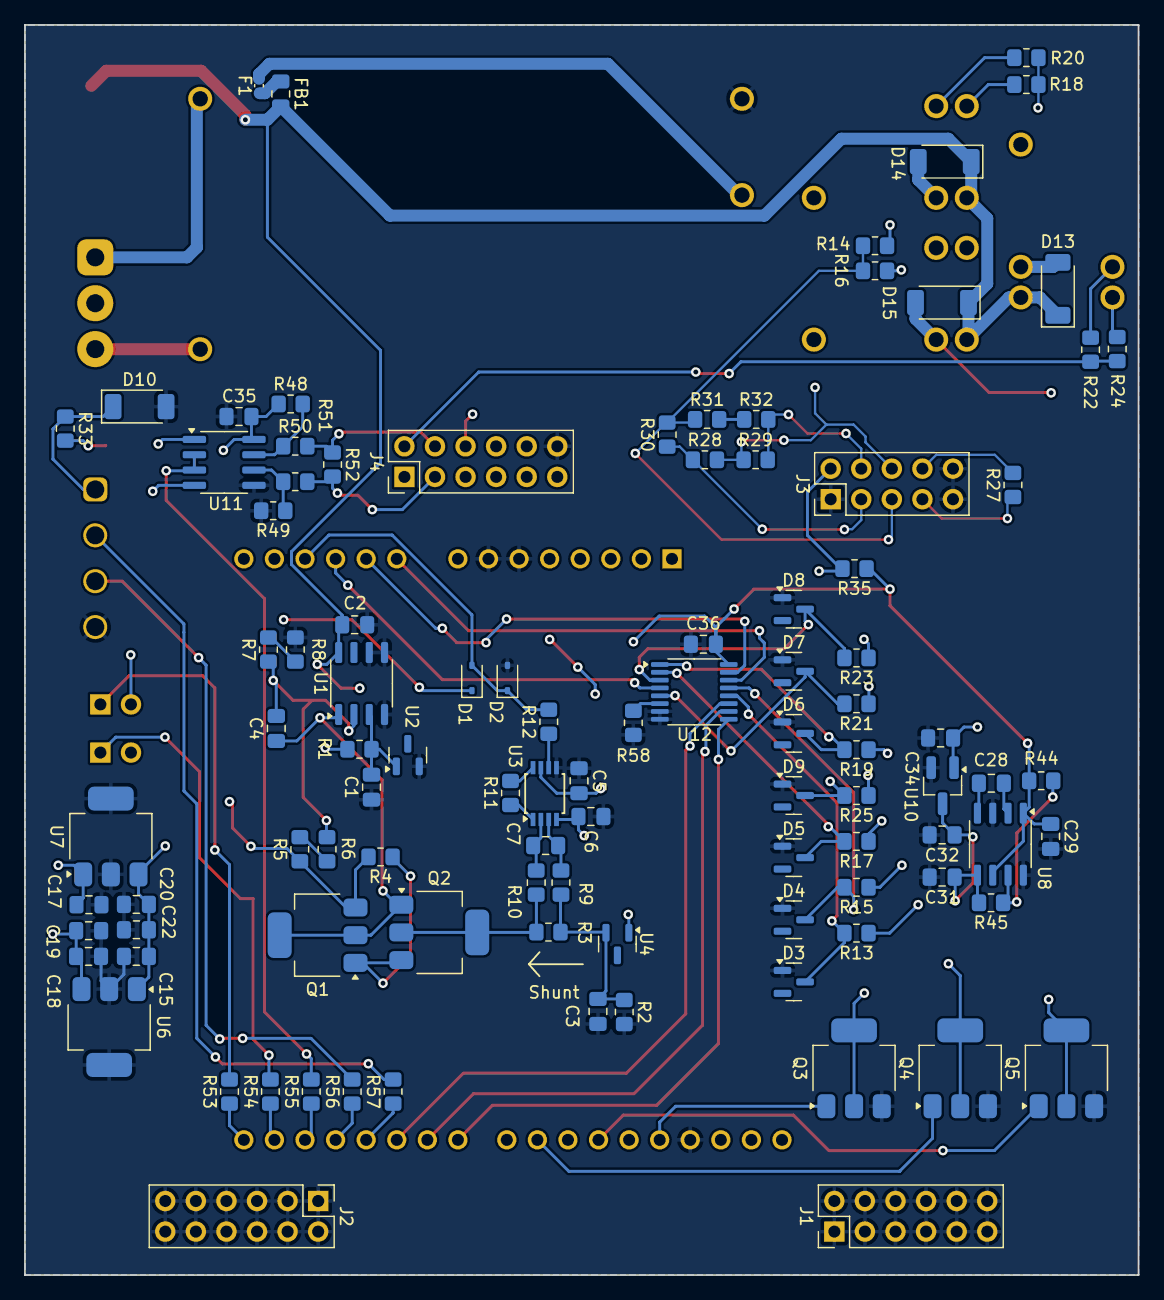
[picture p18: board TestBoardArduino.kicad_pcb from below]

Board: 4 copper layers, 92.5 x 103.8 mm, 111 parts (100 on the bottom side), 88 nets.

Parts:
A1: Arduino_UNO_R3
C1, C2, C5, C6: 0u1F; C_0805_2012Metric_Pad1.18x1.45mm_HandSolder
C3, C15, C35, C36: 0.1uF; C_0805_2012Metric_Pad1.18x1.45mm_HandSolder
C4: 1nF; C_0805_2012Metric_Pad1.18x1.45mm_HandSolder
C7, C18, C19, C20, C22, C29, C31, C32, C34: 10uF; C_0805_2012Metric_Pad1.18x1.45mm_HandSolder
C8: 220uF; CP_Elec_10x10
C17, C28: 1uF; C_0805_2012Metric_Pad1.18x1.45mm_HandSolder
D1, D2: D_Schottky; D_SOD-323
D3: DNM; SOT-23
D4, D5, D6, D7, D8, D9: 3v6; SOT-23
D10, D13, D14, D15: fast; D_SOD-128
D11: Green; LED_0603_1608Metric_Pad1.05x0.95mm_HandSolder
F1: 1A; Fuse_0402_1005Metric_Pad0.77x0.64mm_HandSolder
FB1: MMZ2012Y600BT000; C_0805_2012Metric_Pad1.18x1.45mm_HandSolder
J1: TU; PinHeader_2x06_P2.54mm_Vertical
J2: TD; PinHeader_2x06_P2.54mm_Vertical
J3: PT; PinHeader_2x05_P2.54mm_Vertical
J4: V+RS485; PinHeader_2x06_P2.54mm_Vertical
J5: UART; 3.81mm4PosTerm_2007987
J6, J7: 2.54mm; PinSocket_1x02_P2.54mm_Vertical
J8: 2007986; Screwterminal_3mm81_3pos
K1, K2, K3: MCHRS1KH-S DC24V; MCHRS1KH-S
PS1: IRM-15-24
Q1, Q2: BCP54TA; SOT-223-3_TabPin2
Q3, Q4, Q5: DMN6068SE-13; SOT-223-3_TabPin2
R1, R35: 10k; R_0805_2012Metric_Pad1.20x1.40mm_HandSolder
R2, R44: 100k; R_0805_2012Metric_Pad1.20x1.40mm_HandSolder
R3: 10R 0.1%; R_0805_2012Metric_Pad1.20x1.40mm_HandSolder
R4, R50, R51: 10R; R_0805_2012Metric_Pad1.20x1.40mm_HandSolder
R5: 5Meg6; R_0805_2012Metric_Pad1.20x1.40mm_HandSolder
R6, R9, R10: 160k; R_0805_2012Metric_Pad1.20x1.40mm_HandSolder
R7: 1Meg; R_0805_2012Metric_Pad1.20x1.40mm_HandSolder
R8: 210k; R_0805_2012Metric_Pad1.20x1.40mm_HandSolder
R11, R52: 120R; R_0805_2012Metric_Pad1.20x1.40mm_HandSolder
R12: 100R; R_0805_2012Metric_Pad1.20x1.40mm_HandSolder
R13, R15, R17, R19, R21, R23, R25: 1k; R_0805_2012Metric_Pad1.20x1.40mm_HandSolder
R14, R18, R24, R53, R54, R55, R56, R57, R58: 0R; R_0805_2012Metric_Pad1.20x1.40mm_HandSolder
R16, R20, R22: DNM; R_0805_2012Metric_Pad1.20x1.40mm_HandSolder
R27: 1k 0.1%; R_0805_2012Metric_Pad1.20x1.40mm_HandSolder
R28, R29, R30, R31: 2k; R_0805_2012Metric_Pad1.20x1.40mm_HandSolder
R32: 604R; R_0805_2012Metric_Pad1.20x1.40mm_HandSolder
R33: 320R; R_0805_2012Metric_Pad1.20x1.40mm_HandSolder
R45: 91k; R_0805_2012Metric_Pad1.20x1.40mm_HandSolder
R48, R49: 4k7; R_0805_2012Metric_Pad1.20x1.40mm_HandSolder
U1: MC33172; SO-8_3.9x4.9mm_P1.27mm
U2, U4: LM4040DBZ-2.5; SOT-23
U3: LT6370IMS8#PBF; TSSOP-8_3x3mm_P0.65mm
U6: LM2937IMP-5.0/NOPB; SOT-223-3_TabPin2
U7: LM2940IMP-12/NOPB; SOT-223-3_TabPin2
U8: MAX889TESA+; SO-8_3.9x4.9mm_P1.27mm
U10: XC6902N331MR-G; SOT-23_Handsoldering
U11: MAX485ECSA+; SOIC-8_3.9x4.9mm_P1.27mm
U12: CD4053B; TSSOP-16_4.4x5mm_P0.65mm

Connections:
+1.8VDD: D5.3 (K), R17.2, U12.2 (B0)
+1.8VDD_LPM: J4.7, R17.1
+1.8VIO: D8.3 (K), R23.2, U12.3 (C1)
+1.8VIO_LPM: J4.10, R23.1
+3.0VIO: D6.3 (K), R19.2, U12.1 (B1)
+3.0VIO_LPM: J4.8, R19.1
+5V: C18.1, C19.1, C29.1, C35.1, C36.1, D1.1 (K), R35.1, R44.2, R48.1, U6.3 (VO), U8.1 (IN), U8.6 (/SHDN), U11.8 (VCC), U12.16 (VDD)
+5VP: D10.1 (K), J5.1, R33.1
+12V: A1.8 (VIN), C15.1, C20.1, C22.1, U6.1 (VI), U7.3 (VO)
+24V: C2.2, C5.2, C8.1, C17.1, D13.1 (K), D14.1 (K), D15.1 (K), FB1.2, K1.3, K2.3, K3.3, R1.1, U1.8 (V+), U3.7 (V+), U4.1 (K), U7.1 (VI)
+BATT: J4.2, R22.1, R24.1
+RS485: J4.3, R51.2, R52.1
-3V3: C6.1, C34.1, U3.4 (V-), U10.1 (-VOUT)
-RS485: J4.4, R50.2, R52.2
B+: J3.5, R14.1, R16.1, R30.2, R31.1
B-: J3.6, K3.5, R28.2, R29.1
BLE_VDD: A1.13 (SDA/A4), D9.3 (K), R25.2
BLE_VDD_LPM: J4.11, R25.1
CORE_VDD: D4.3 (K), R15.2, U12.13 (A1)
CORE_VDD_LPM: J4.6, R15.1
Dout: A1.23 (D8), J3.2, R35.2
EN_BAT: A1.28 (D13), Q3.1 (G)
EN_RX/TX: R55.2, U11.2 (~RE), U11.3 (DE)
GND: A1.6 (GND), A1.7 (GND), A1.29 (GND), C1.1, C2.1, C3.2, C5.1, C6.2, C8.2, C15.2, C17.2, C18.2, C19.2, C20.2, C22.2, C29.2, C31.2, C32.2, C34.2, C35.2, C36.2, D2.2 (A), D3.1 (A), D4.1 (A), D5.1 (A), D6.1 (A), D7.1 (A), D8.1 (A), D9.1 (A), D10.2 (A), D11.1 (K), J1.1, J1.2, J1.3, J1.4, J1.5, J1.6, J1.7, J1.8, J1.9, J1.10, J1.11, J1.12, J2.1, J2.2, J2.3, J2.4, J2.5, J2.6, J2.7, J2.8, J2.9, J2.10, J2.11, J2.12, J3.1, J3.9, J3.10, J4.12, J5.4, PS1.3 (-Vo), Q3.3 (S), Q4.3 (S), Q5.3 (S), R2.2, R8.2, R49.2, R58.2, U1.4 (V-), U1.5 (+), U1.6 (-), U2.2 (A), U3.5 (Ref), U6.2 (GND), U7.2 (GND), U8.3 (GND), U8.8 (AGND), U10.2 (GND), U11.5 (GND), U12.7 (VEE), U12.8 (VSS)
IOUT: A1.12 (A3), D1.2 (A), D2.1 (K), R12.2
unnamed: A1.9 (A0), U12.14 (A)
unnamed: A1.10 (A1), U12.15 (B)
unnamed: A1.11 (A2), U12.4 (C)
unnamed: A1.15 (D0/RX), R53.1
unnamed: A1.16 (D1/TX), R54.1
unnamed: A1.17 (D2), R55.1
unnamed: A1.18 (D3), R56.1
unnamed: A1.19 (D4), R57.1
unnamed: D11.2 (A), R33.2
unnamed: D13.2 (A), K1.4, Q3.2 (D)
unnamed: D14.2 (A), K2.4, Q4.2 (D)
unnamed: D15.2 (A), K3.4, Q5.2 (D)
unnamed: F1.1, FB1.1
unnamed: J8.1, PS1.1 (AC/N)
unnamed: J8.3, PS1.2 (AC/L)
unnamed: K1.1, R24.2
unnamed: K1.2, R22.2
unnamed: K2.1, R18.2
unnamed: K2.2, R20.2
unnamed: K3.1, R14.2
unnamed: K3.2, R16.2
unnamed: F1.2, PS1.4 (+Vo)
unnamed: Q1.1 (B), Q2.3 (E), R4.1
unnamed: K1.5, Q1.3 (E), R4.2, R5.1
unnamed: C4.1, Q1.2 (C), Q2.1 (B), U1.1
unnamed: Q2.2 (C), R3.2, R10.1
unnamed: R5.2, R6.1
unnamed: R7.2, R8.1
unnamed: R31.2, R32.1
unnamed: C1.2, R1.2, U1.3 (+), U2.1 (K)
unnamed: C4.2, R6.2, R7.1, U1.2 (-)
unnamed: C7.1, R9.2, U3.3 (IN+)
unnamed: C7.2, R10.2, U3.2 (IN-)
unnamed: R12.1, U3.6 (OUT)
unnamed: R11.2, U3.8 (Rg+)
unnamed: R11.1, U3.1 (Rg-)
unnamed: C3.1, R2.1, R3.1, R9.1, U4.2 (A)
unnamed: C28.1, U8.2 (CAP+)
unnamed: C28.2, U8.4 (CAP-)
unnamed: R44.1, R45.1, U8.7 (FB)
unnamed: C31.1, C32.1, R45.2, U8.5 (OUT), U10.3 (-IN)
unnamed: R49.1, R51.1, U11.6 (A)
unnamed: R48.2, R50.1, U11.7 (B)
unnamed: R58.1, U12.6 (INH)
RX: J6.2, U11.1 (RO)
S1: A1.20 (D5), U12.11 (S1)
S2: A1.21 (D6), U12.10 (S2)
S3: A1.22 (D7), U12.9 (S3)
SHRT_P: A1.26 (D11), Q5.1 (G)
SHRT_T: A1.24 (D9), Q4.1 (G)
T+: J3.7, R18.1, R20.1, R27.1
T-: J3.8, K2.5, R27.2
TX: J7.2, U11.4 (DI)
UART_RX: J6.1, R53.2
UART_S_RX: J5.3, R56.2
UART_S_TX: J5.2, R57.2
UART_TX: J7.1, R54.2
VB+: J3.3, R28.1, R30.1
VB-: J3.4, R29.2, R32.2
VCC_MAIN: D3.3 (K), R13.2, U12.12 (A0)
VCC_MAIN_LPM: J4.5, R13.1
VPP_2V5: D7.3 (K), R21.2, U12.5 (C0)
VPP_2V5_LPM: J4.9, R21.1
