davidholmes1066/LPM_Production_TT/Boards/USB/USB.kicad_pcb

## KiCad design Boards/USB/USB.kicad_pcb (2023-02-11)

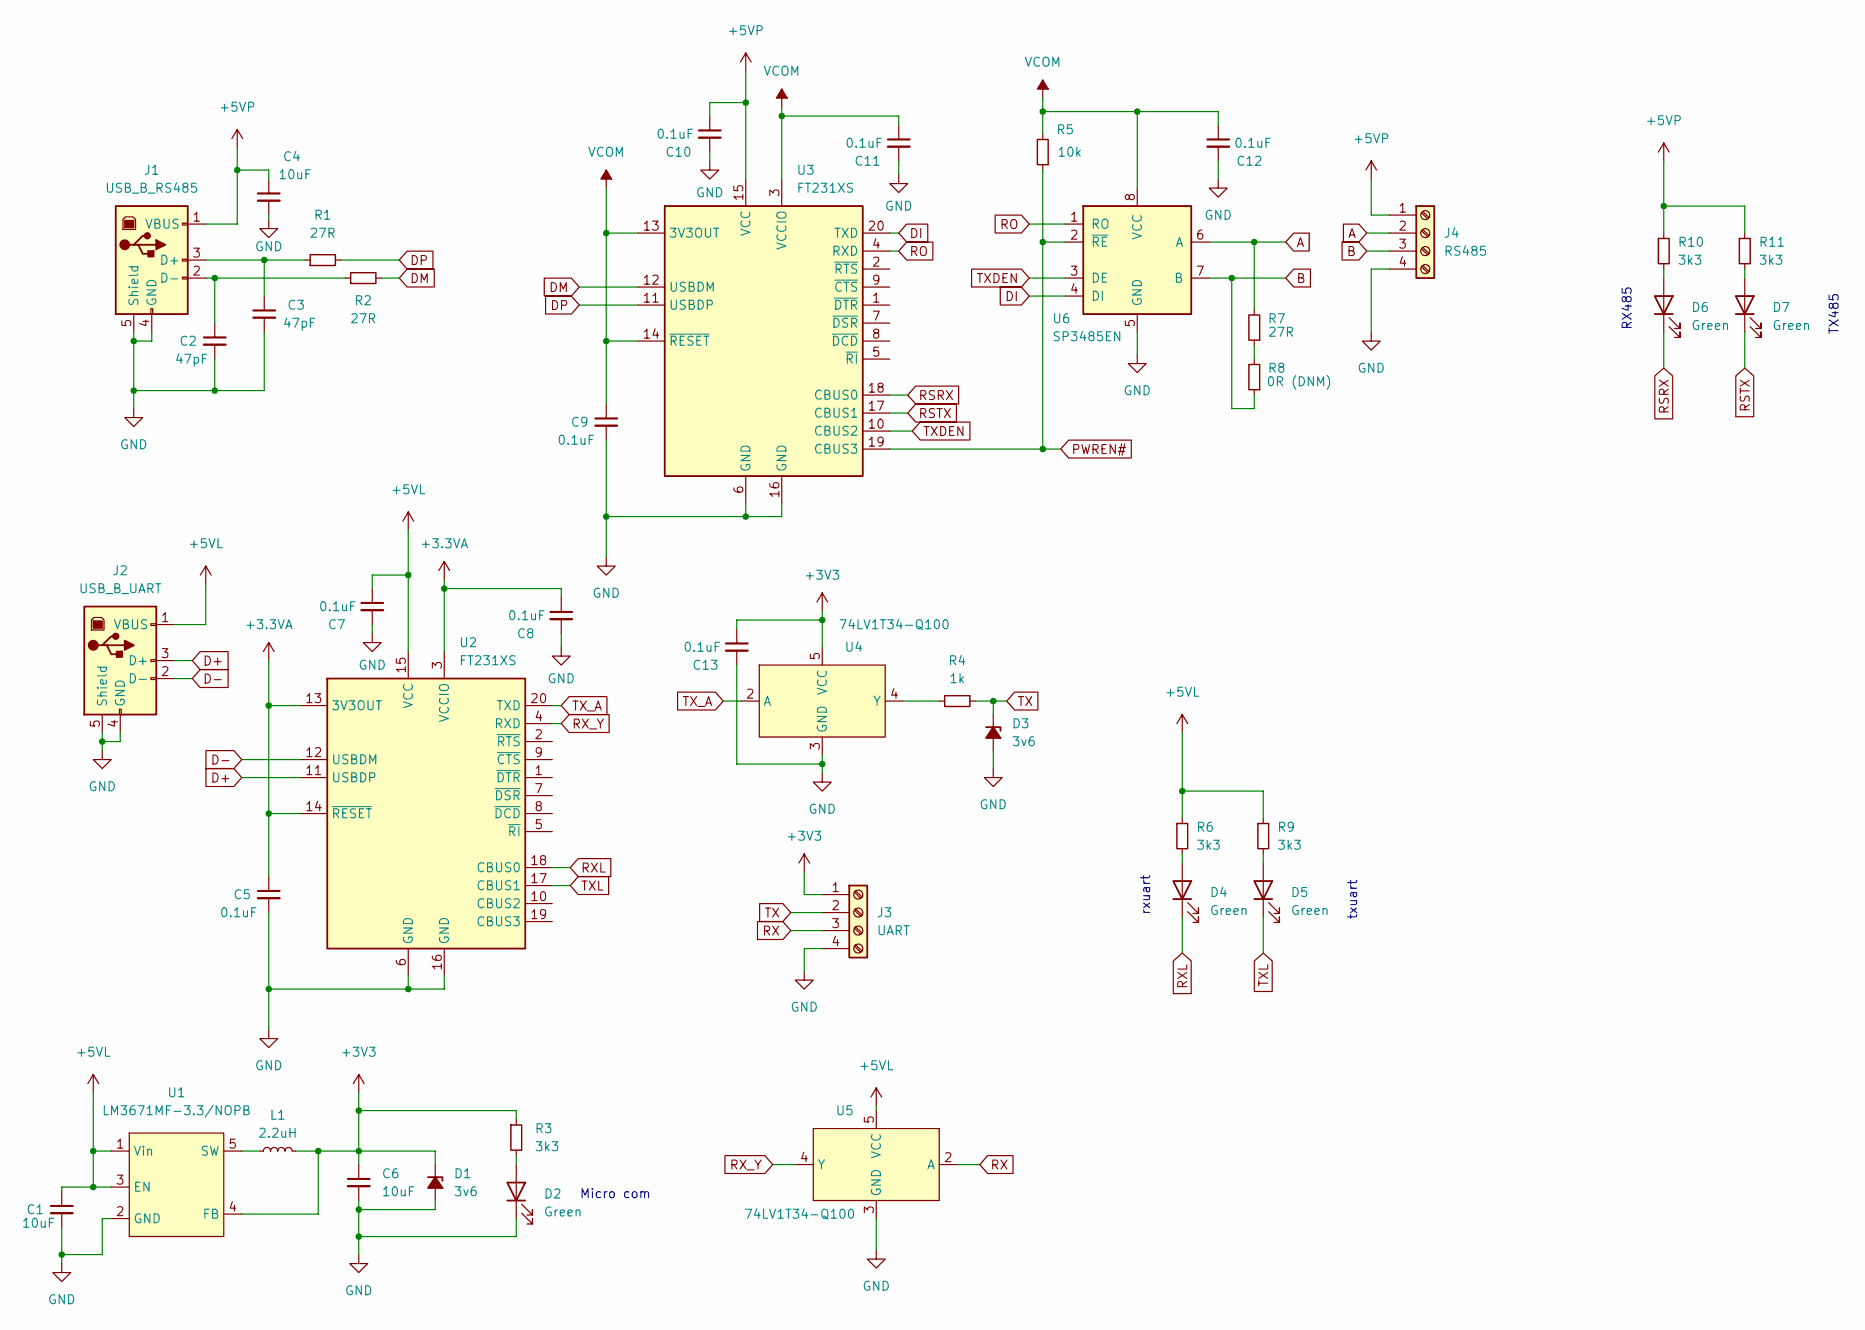
[picture p19: schematic USB.kicad_sch]

Parts:
C1, C4, C6: 10uF; C_0805_2012Metric_Pad1.18x1.45mm_HandSolder
C2, C3: 47pF; C_0805_2012Metric_Pad1.18x1.45mm_HandSolder
C5, C7, C8, C9, C10, C11, C12, C13: 0.1uF; C_0805_2012Metric_Pad1.18x1.45mm_HandSolder
D1, D3: 3v6; BZX84C3V6; Farnell 1902466
D2, D4, D5, D6, D7: Green; LED_0402_1005Metric_Pad0.77x0.64mm_HandSolder; Farnell 2507544
J1: USB_B_RS485; USB_B
J2: USB_B_UART; USB_B
J3: UART; Screwterminal_3mm81_4pos
J4: RS485; Screwterminal_3mm81_4pos
L1: 2.2uH; 0805_PInductor; Farnell 3865051
R1, R2, R7: 27R; R_0805_2012Metric_Pad1.20x1.40mm_HandSolder
R3, R6, R9, R10, R11: 3k3; R_0805_2012Metric_Pad1.20x1.40mm_HandSolder
R4: 1k; R_0805_2012Metric_Pad1.20x1.40mm_HandSolder
R5: 10k; R_0805_2012Metric_Pad1.20x1.40mm_HandSolder
R8: 0R (DNM); R_0805_2012Metric_Pad1.20x1.40mm_HandSolder
U1: LM3671MF-3.3/NOPB; SOT-23-5_HandSoldering; Farnell 3008192
U2, U3: FT231XS; SSOP-20_3.9x8.7mm_P0.635mm
U4, U5: 74LV1T34-Q100; 74LV1T34GV-Q100H
U6: SP3485EN; SOIC-8_3.9x4.9mm_P1.27mm

Connections:
+3.3VA: C5.1, C8.1, U2.3 (VCCIO), U2.13 (3V3OUT), U2.14 (~RESET)
+3V3: C6.1, C13.1, D1.1 (K), J3.1, L1.2, R3.1, U1.4 (FB), U4.5 (VCC)
+5VL: C1.1, C7.1, J2.1 (VBUS), R6.1, R9.1, U1.1 (Vin), U1.3 (EN), U2.15 (VCC), U5.5 (VCC)
+5VP: C4.1, C10.1, J1.1 (VBUS), J4.1, R10.1, R11.1, U3.15 (VCC)
A: J4.2, R7.2, U6.6 (A)
B: J4.3, R8.1, U6.7 (B)
D+: J2.3 (D+), U2.11 (USBDP)
D-: J2.2 (D-), U2.12 (USBDM)
DI: U3.20 (TXD), U6.4 (DI)
DM: R2.2, U3.12 (USBDM)
DP: R1.2, U3.11 (USBDP)
GND: C1.2, C2.2, C3.2, C4.2, C5.2, C6.2, C7.2, C8.2, C9.2, C10.2, C11.2, C12.2, C13.2, D1.2 (A), D2.1 (K), D3.2 (A), J1.4 (GND), J1.5 (Shield), J2.4 (GND), J2.5 (Shield), J3.4, J4.4, U1.2 (GND), U2.6 (GND), U2.16 (GND), U3.6 (GND), U3.16 (GND), U4.3 (GND), U5.3 (GND), U6.5 (GND)
unnamed: D2.2 (A), R3.2
unnamed: D4.2 (A), R6.2
unnamed: D5.2 (A), R9.2
unnamed: D6.2 (A), R10.2
unnamed: D7.2 (A), R11.2
unnamed: C2.1, J1.2 (D-), R2.1
unnamed: C3.1, J1.3 (D+), R1.1
unnamed: L1.1, U1.5 (SW)
unnamed: R4.1, U4.4 (Y)
unnamed: R7.1, R8.2
PWREN#: R5.1, U3.19 (CBUS3), U6.2 (~RE)
RO: U3.4 (RXD), U6.1 (RO)
RSRX: D6.1 (K), U3.18 (CBUS0)
RSTX: D7.1 (K), U3.17 (CBUS1)
RX: J3.3, U5.2 (A)
RXL: D4.1 (K), U2.18 (CBUS0)
RX_Y: U2.4 (RXD), U5.4 (Y)
TX: D3.1 (K), J3.2, R4.2
TXDEN: U3.10 (CBUS2), U6.3 (DE)
TXL: D5.1 (K), U2.17 (CBUS1)
TX_A: U2.20 (TXD), U4.2 (A)
VCOM: C9.1, C11.1, C12.1, R5.2, U3.3 (VCCIO), U3.13 (3V3OUT), U3.14 (~RESET), U6.8 (VCC)

Notes on the sheet:
rxuart
Micro com
RX485
TX485
txuart

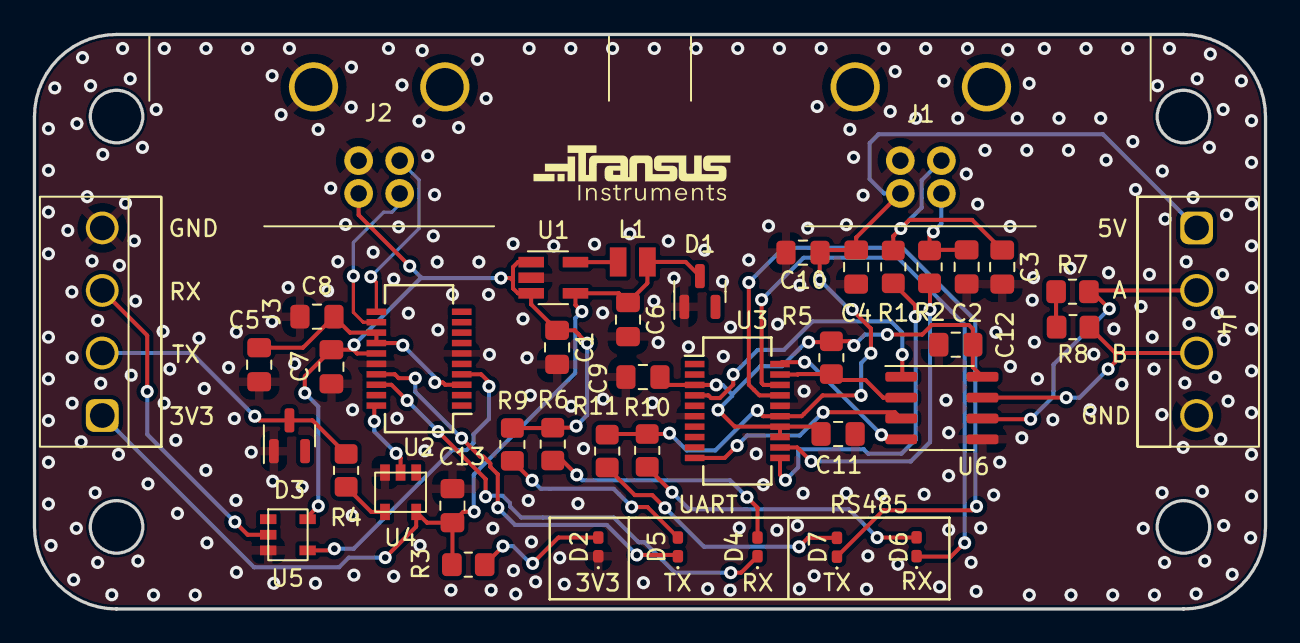
[picture p20: board USB.kicad_pcb from above]

Board: 2 copper layers, 75.0 x 35.0 mm, 42 parts (0 on the bottom side), 34 nets.
