davidholmes1066/LPM_Production_TT/Boards/Screen/Screen.kicad_pcb

## KiCad design Boards/Screen/Screen.kicad_pcb (2023-02-11)

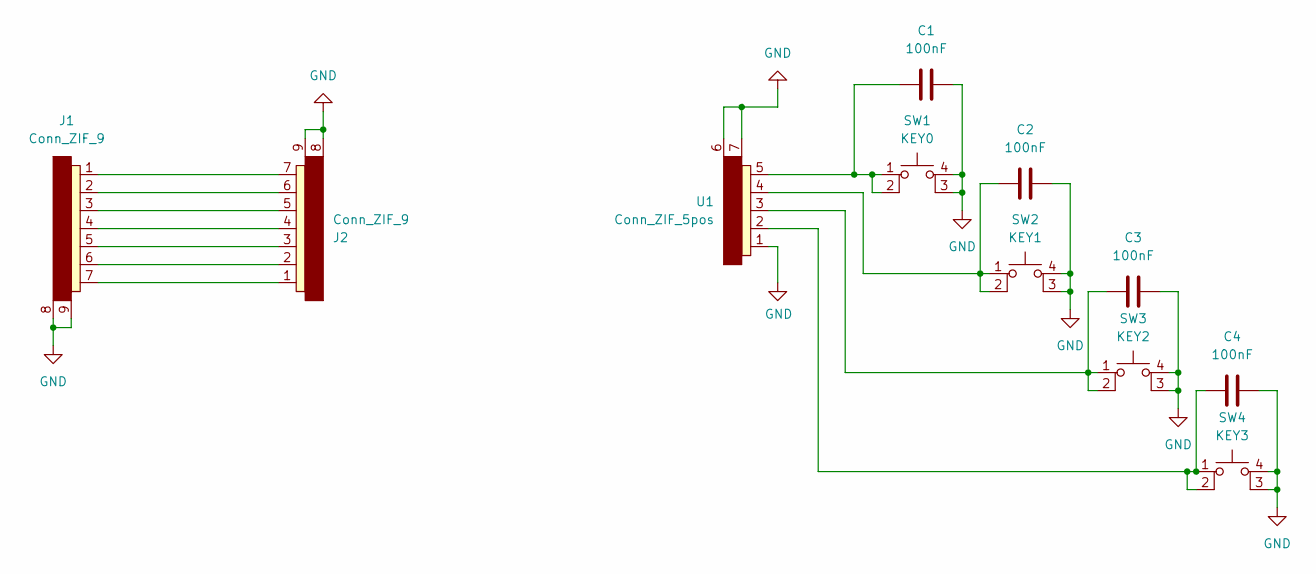
[picture p21: schematic Screen.kicad_sch, LPM PT Screen]

Parts:
C1, C2, C3, C4: 100nF; C_0805_2012Metric_Pad1.18x1.45mm_HandSolder
J1, J2: Conn_ZIF_9; Conn_ZIF_7pos
SW1: KEY0; Tactile_button_Frn1775334
SW2: KEY1; Tactile_button_Frn1775334
SW3: KEY2; Tactile_button_Frn1775334
SW4: KEY3; Tactile_button_Frn1775334
U1: Conn_ZIF_5pos

Connections:
GND: C1.2, C2.2, C3.2, C4.2, J1.8, J1.9, J2.8, J2.9, SW1.3 (K), SW1.4 (A), SW2.3 (K), SW2.4 (A), SW3.3 (K), SW3.4 (A), SW4.3 (K), SW4.4 (A), U1.1, U1.6, U1.7
unnamed: C1.1, SW1.1, SW1.2, U1.5
unnamed: C2.1, SW2.1, SW2.2, U1.4
unnamed: J1.1, J2.7
unnamed: J1.2, J2.6
unnamed: J1.3, J2.5
unnamed: J1.4, J2.4
unnamed: J1.5, J2.3
unnamed: J1.6, J2.2
unnamed: J1.7, J2.1
unnamed: C4.1, SW4.1, SW4.2, U1.2
unnamed: C3.1, SW3.1, SW3.2, U1.3

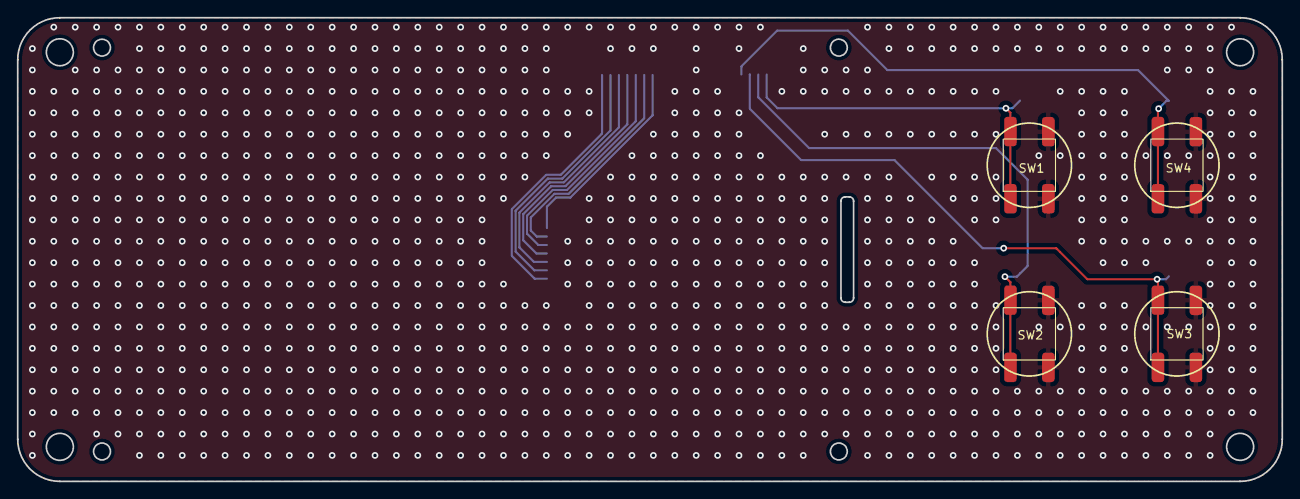
[picture p22: board Screen.kicad_pcb from above]

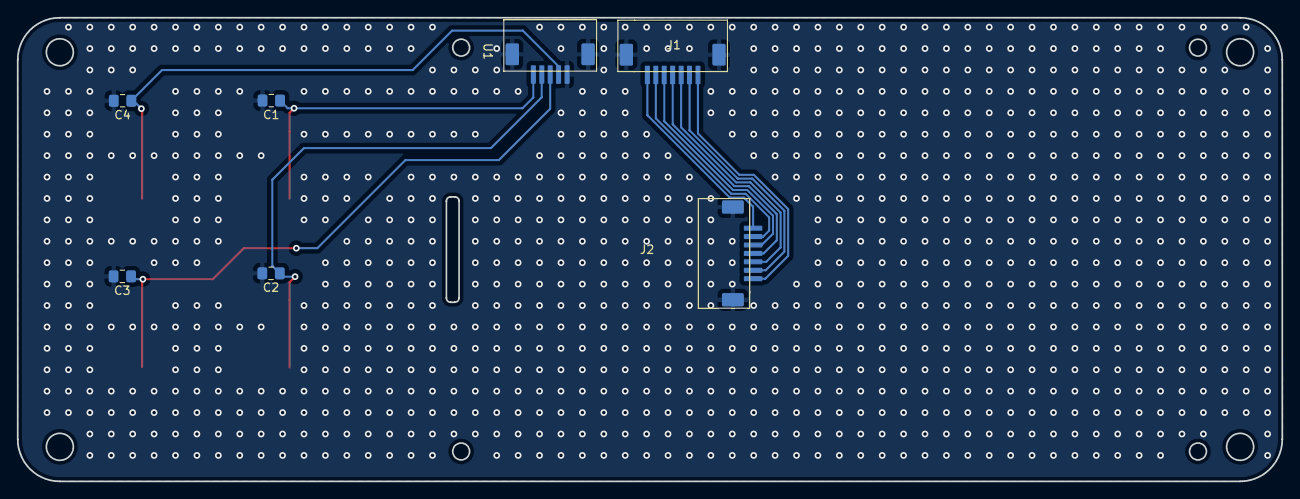
[picture p23: board Screen.kicad_pcb from below]

Board: 2 copper layers, 150.0 x 55.0 mm, 11 parts (7 on the bottom side), 12 nets.
