davidholmes1066/LPM_Production_TT/(commit log)

2023-02-11 Added Board-,embedded and matlab gui files
    [123TestBatch_11-02-2023.xlsx, BedOfNailsLPM.kicad_pcb, BedOfNailsLPM.kicad_sch, Bed_of_nails-B_Silkscreen.dxf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]
2023-02-13 Added excel to gui
    [123456_11-02-2023.xlsx, 1354Test_11-02-2023.xlsx, TEST_12-02-2023.xlsx, hallo_11-02-2023.xlsx, history.csv, test123_11-02-2023.xlsx, testbatch123_11-02-2023.xlsx]
2023-03-22 Figuring out why supply cal not working
    [BedOfNailsLPM.kicad_pcb, BedOfNailsLPM.kicad_sch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]
2023-05-09 ReadVolt converted to floats
    Will still need to convert some of the other functions to be standalone
    [12344_11-04-2023.xlsx, 1234567_20-04-2023.xlsx, 123456_11-04-2023.xlsx, 1234_11-04-2023.xlsx, 123_11-04-2023.xlsx, 2345678_11-04-2023.xlsx, 234567_20-04-2023.xlsx, 23456_11-04-2023.xlsx]
2023-06-29 Added python code
    [123456789_23-06-2023.xlsx, 12345678_23-06-2023.xlsx, 1234567_23-06-2023.xlsx, 123TestBatch_29-06-2023.xlsx, 12678_23-06-2023.xlsx, 2345678_23-06-2023.xlsx, 234567_23-06-2023.xlsx, 234678_23-06-2023.xlsx]
2024-06-26 added relay
    Still needs better separation between the AC lines and footprints relay need fixing
    [Bed_of_nails-B_Adhesive.gbr, Bed_of_nails-B_Cu.gbr, Bed_of_nails-B_Mask.gbr, Bed_of_nails-B_Paste.gbr, Bed_of_nails-B_Silkscreen.gbr, Bed_of_nails-Edge_Cuts.gbr, Bed_of_nails-F_Adhesive.gbr, Bed_of_nails-F_Cu.gbr]
2024-07-11 Updated board
    [Connectors.kicad_sch, PS.kicad_sch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]
